johnkustin/bandgapReferenceCircuit/plots/ideal_amp/closed-loop-gain-pos-neg-vs-temp.png

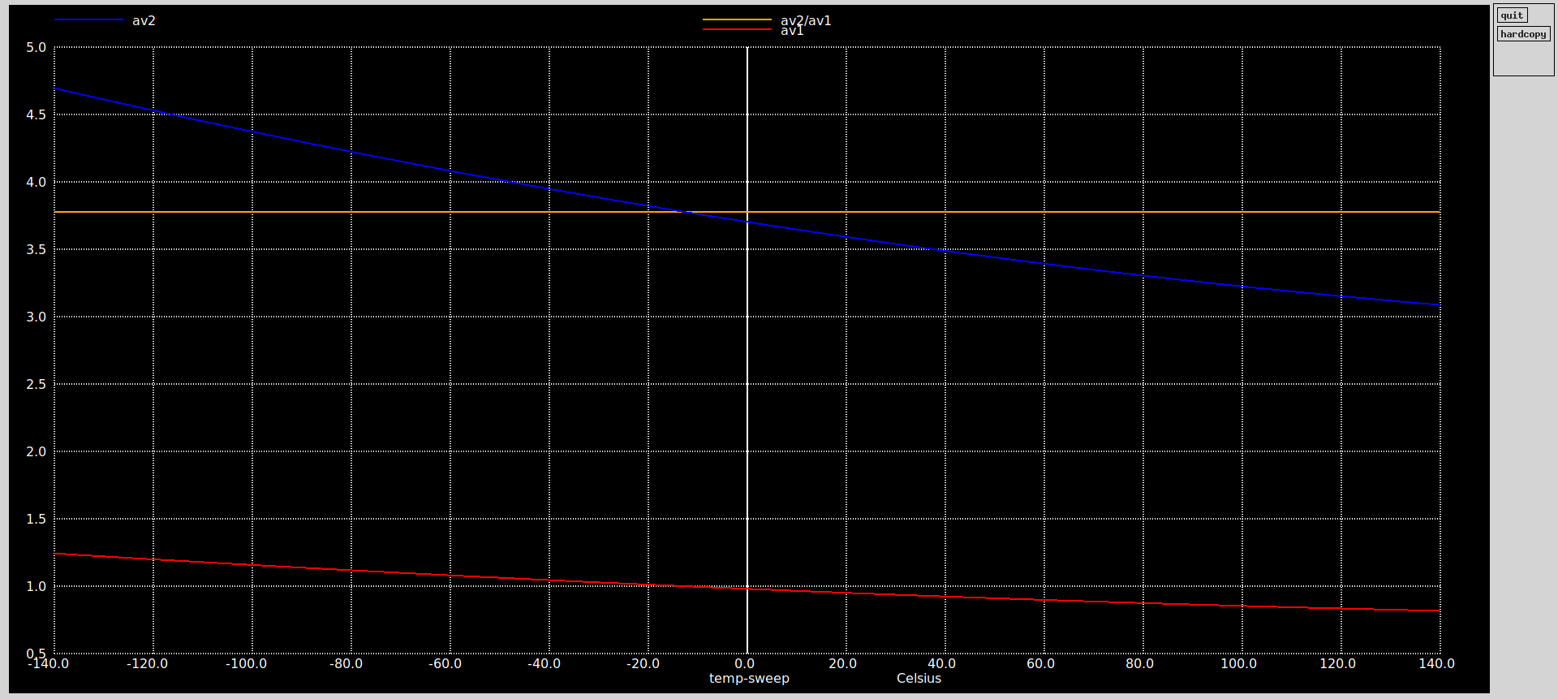
plots/ideal_amp/closed-loop-gain-pos-neg-vs-temp.png
