johnkustin/bandgapReferenceCircuit/plots/ideal_amp/current-vs-temp.png

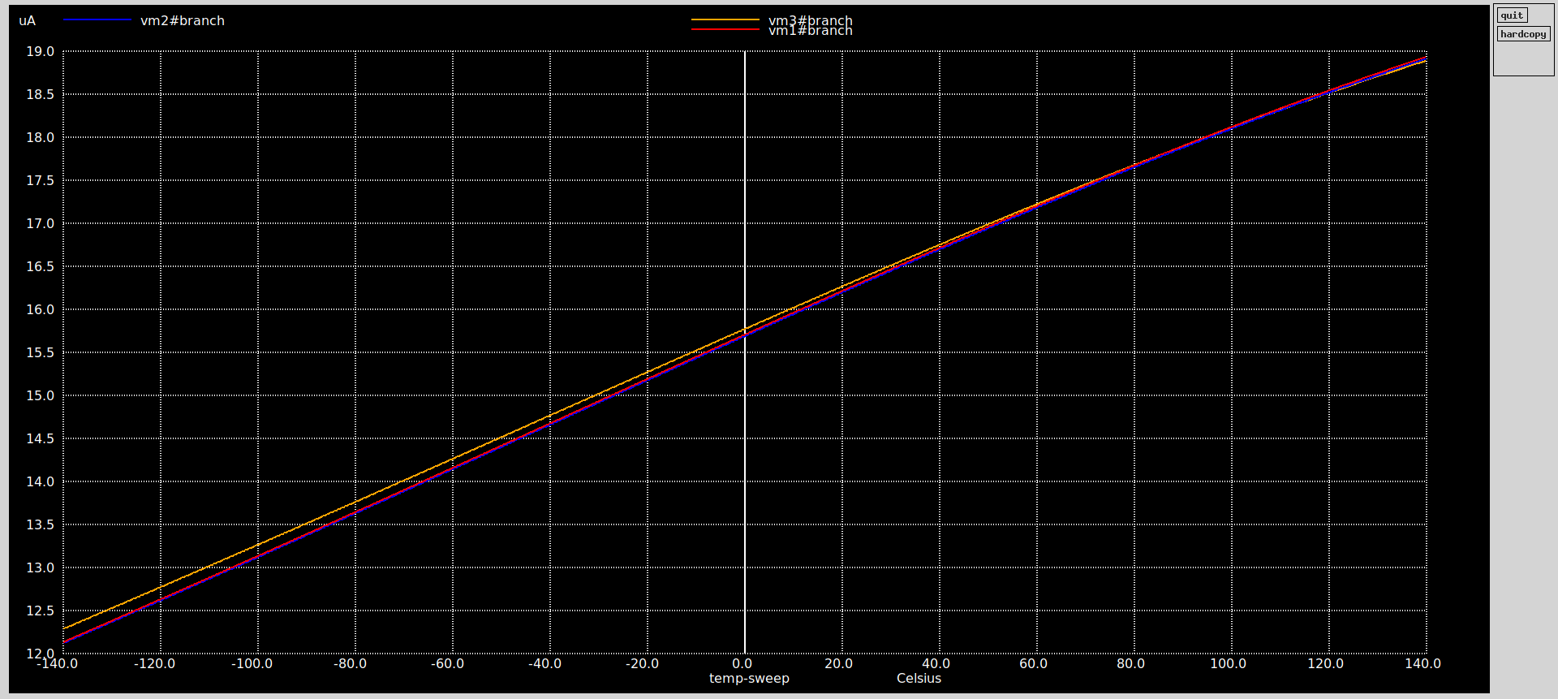
plots/ideal_amp/current-vs-temp.png
