johnkustin/bandgapReferenceCircuit/plots/ideal_amp/deriv-veb-deriv-vptat-vs-temp-zoomed.png

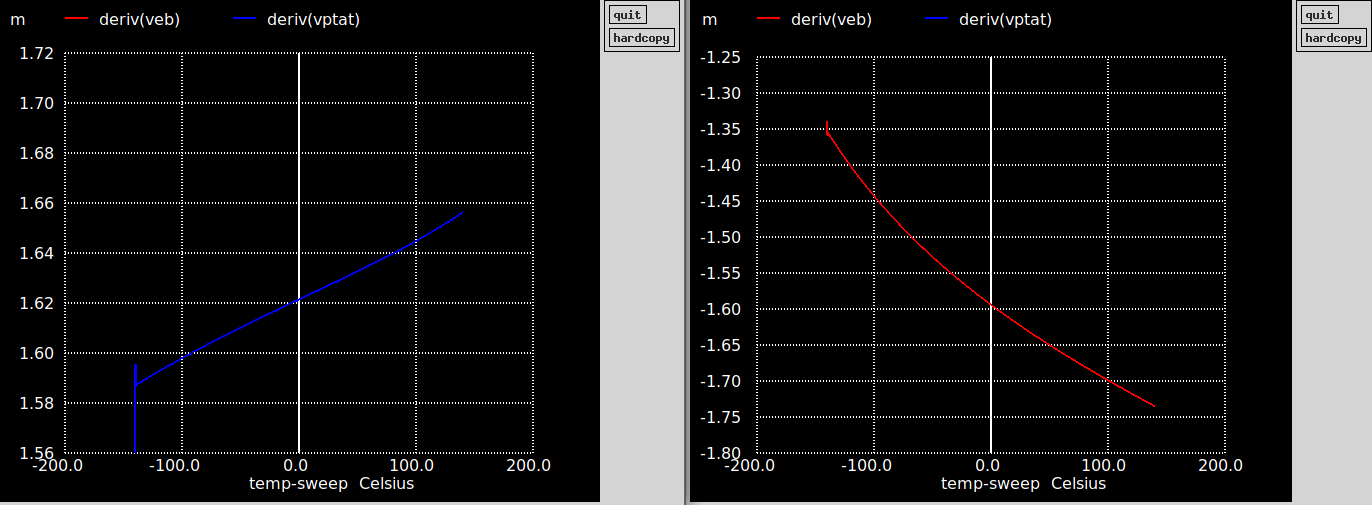
plots/ideal_amp/deriv-veb-deriv-vptat-vs-temp-zoomed.png
