johnkustin/bandgapReferenceCircuit/plots/ideal_amp/deriv-veb-deriv-vptat-vs-temp.png

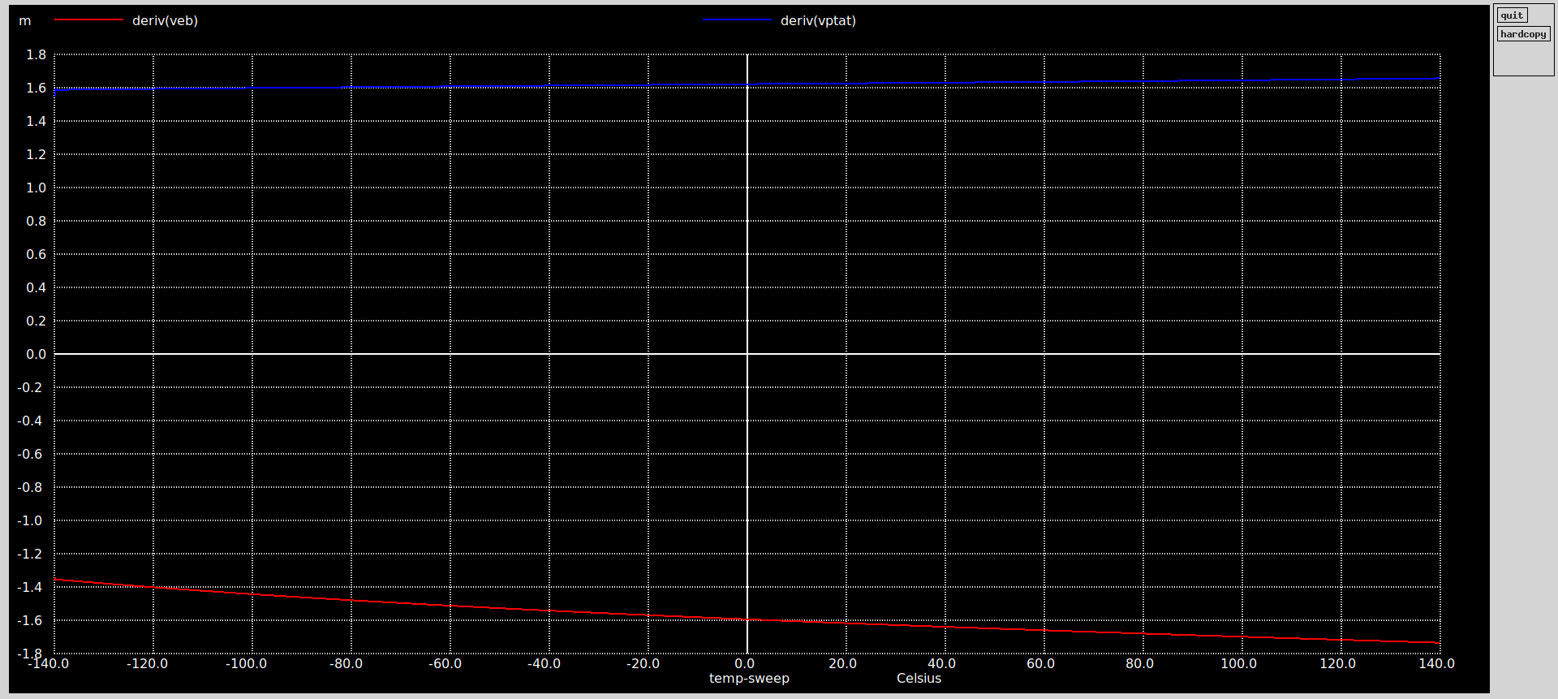
plots/ideal_amp/deriv-veb-deriv-vptat-vs-temp.png
