johnkustin/bandgapReferenceCircuit/plots/ideal_amp/ppm-vs-temp.png

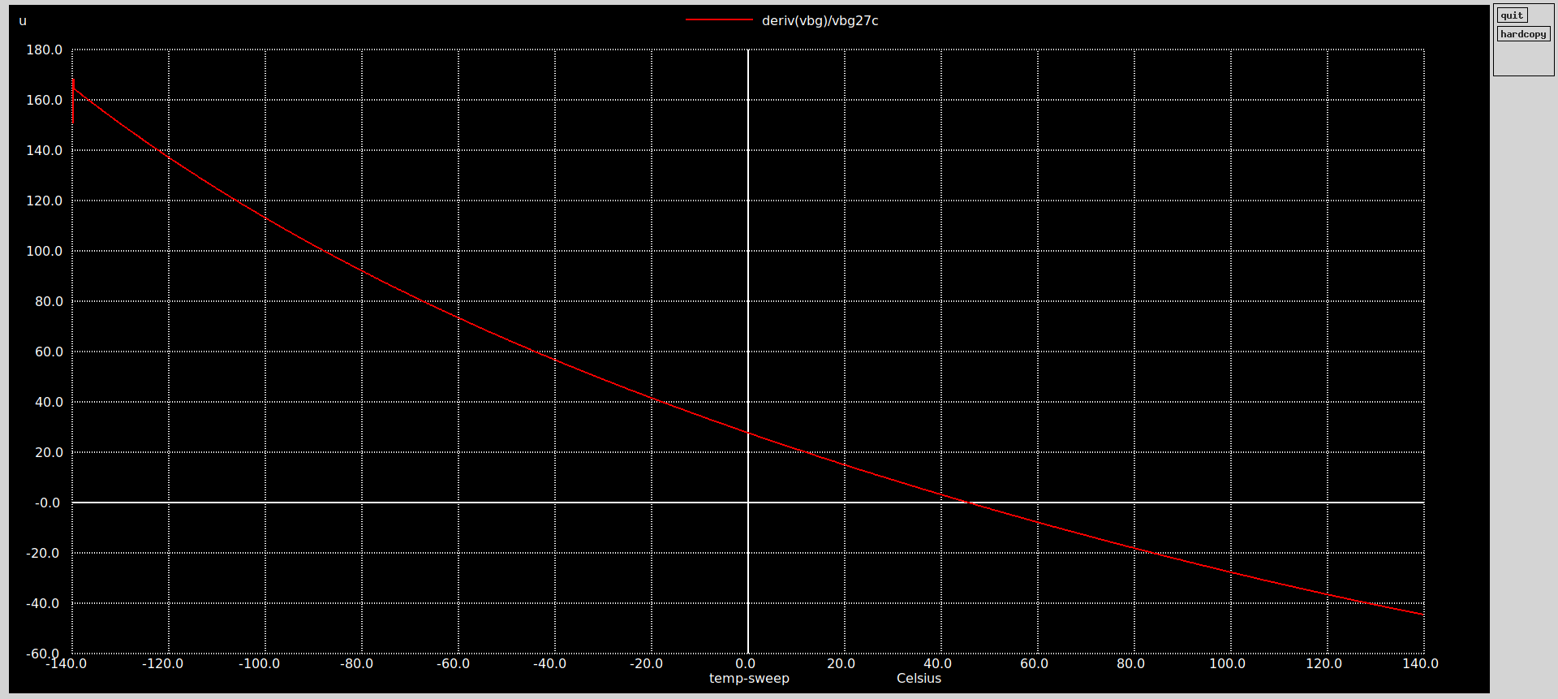
plots/ideal_amp/ppm-vs-temp.png
