johnkustin/bandgapReferenceCircuit/plots/ideal_amp/saturation-cond-vs-temp.png

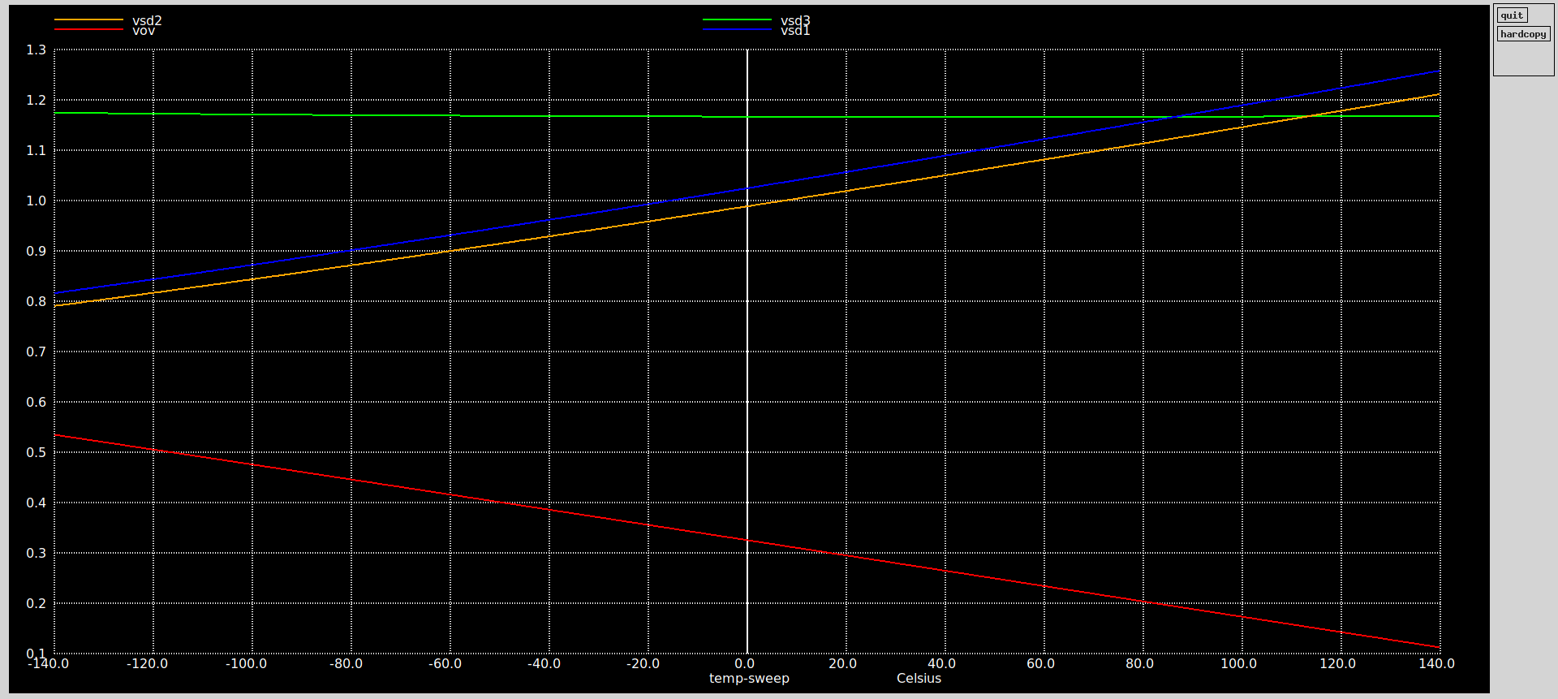
plots/ideal_amp/saturation-cond-vs-temp.png
