johnkustin/bandgapReferenceCircuit/plots/ideal_amp/vbg-vs-temp.png

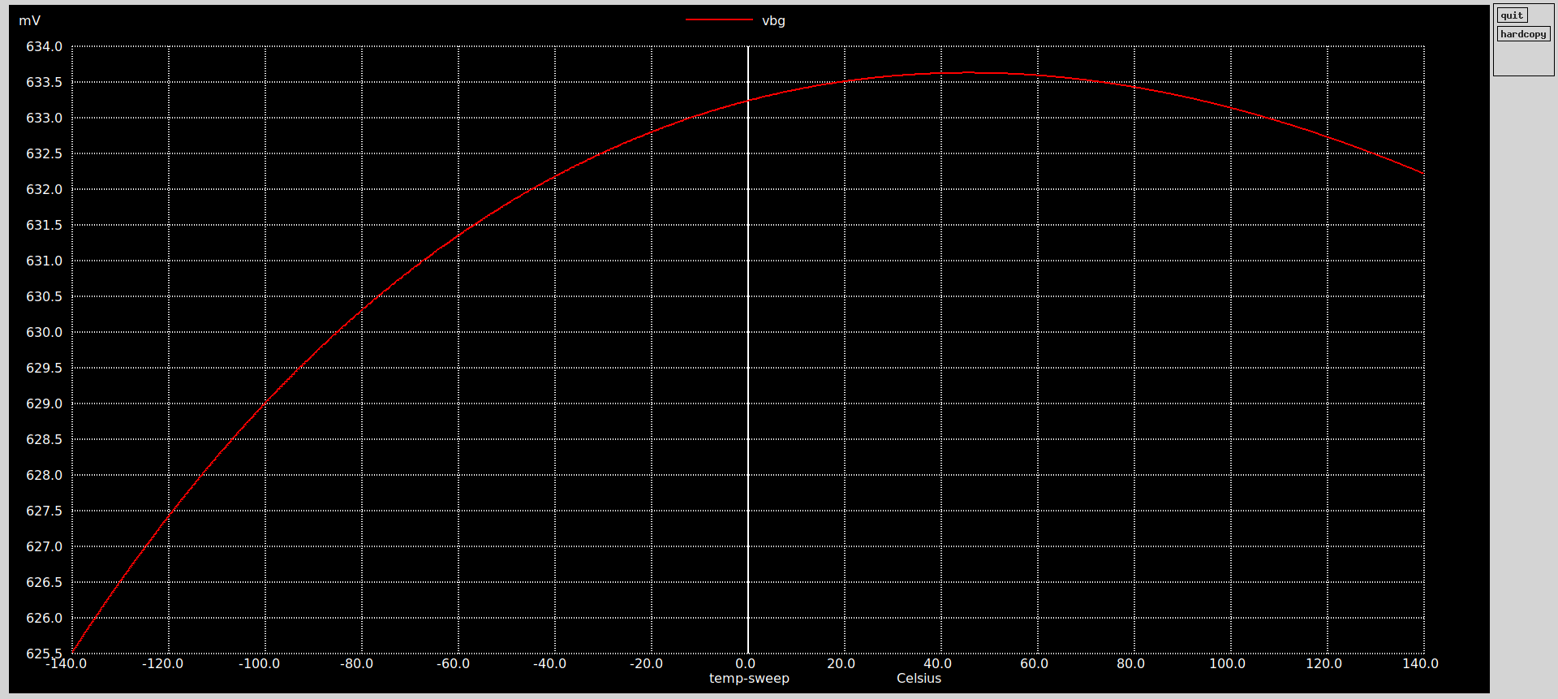
plots/ideal_amp/vbg-vs-temp.png
