johnkustin/bandgapReferenceCircuit/plots/ideal_amp/veb-vptat-sum-vs-temp.png

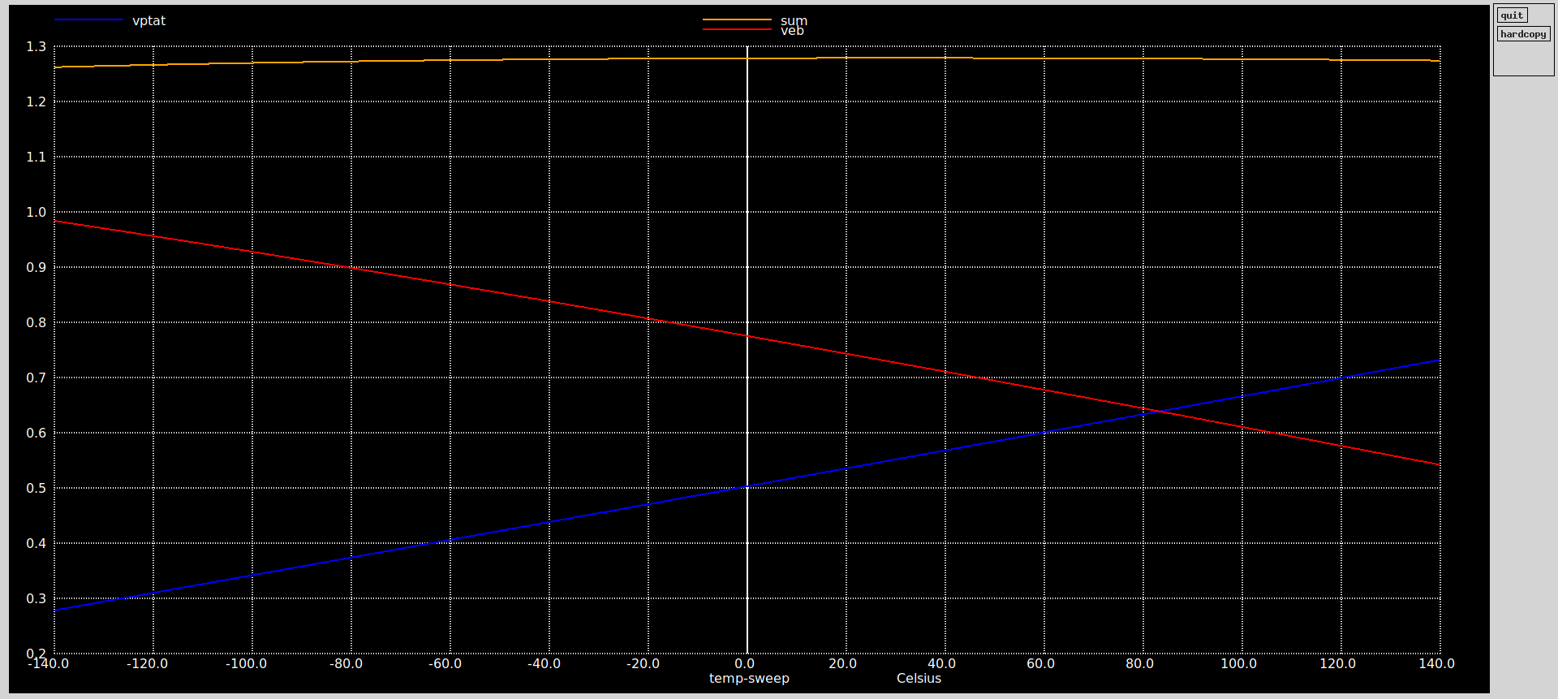
plots/ideal_amp/veb-vptat-sum-vs-temp.png
