johnkustin/bandgapReferenceCircuit/plots/ideal_amp_pdk_res/deriv-vbg-vs-temp.png

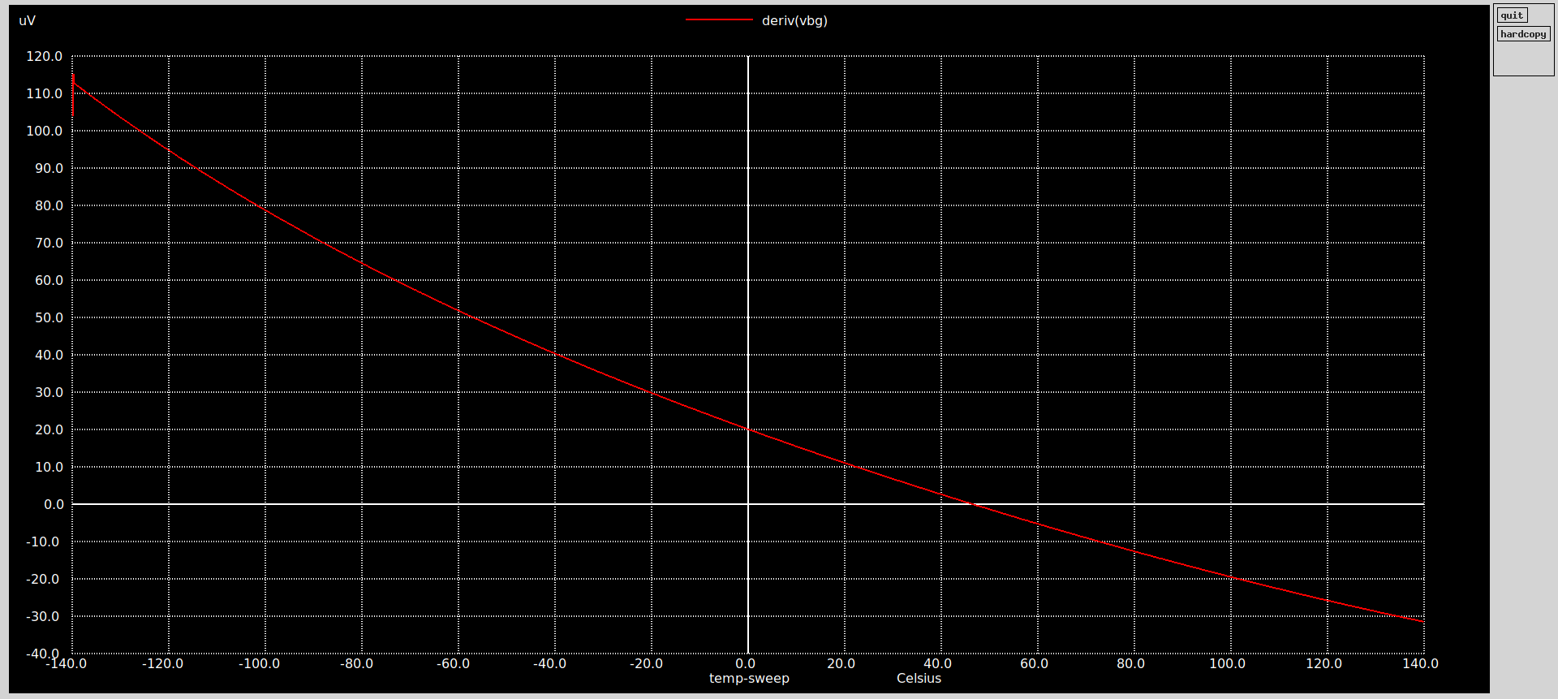
plots/ideal_amp_pdk_res/deriv-vbg-vs-temp.png
