johnkustin/bandgapReferenceCircuit/plots/ideal_amp_pdk_res/TCratio.png

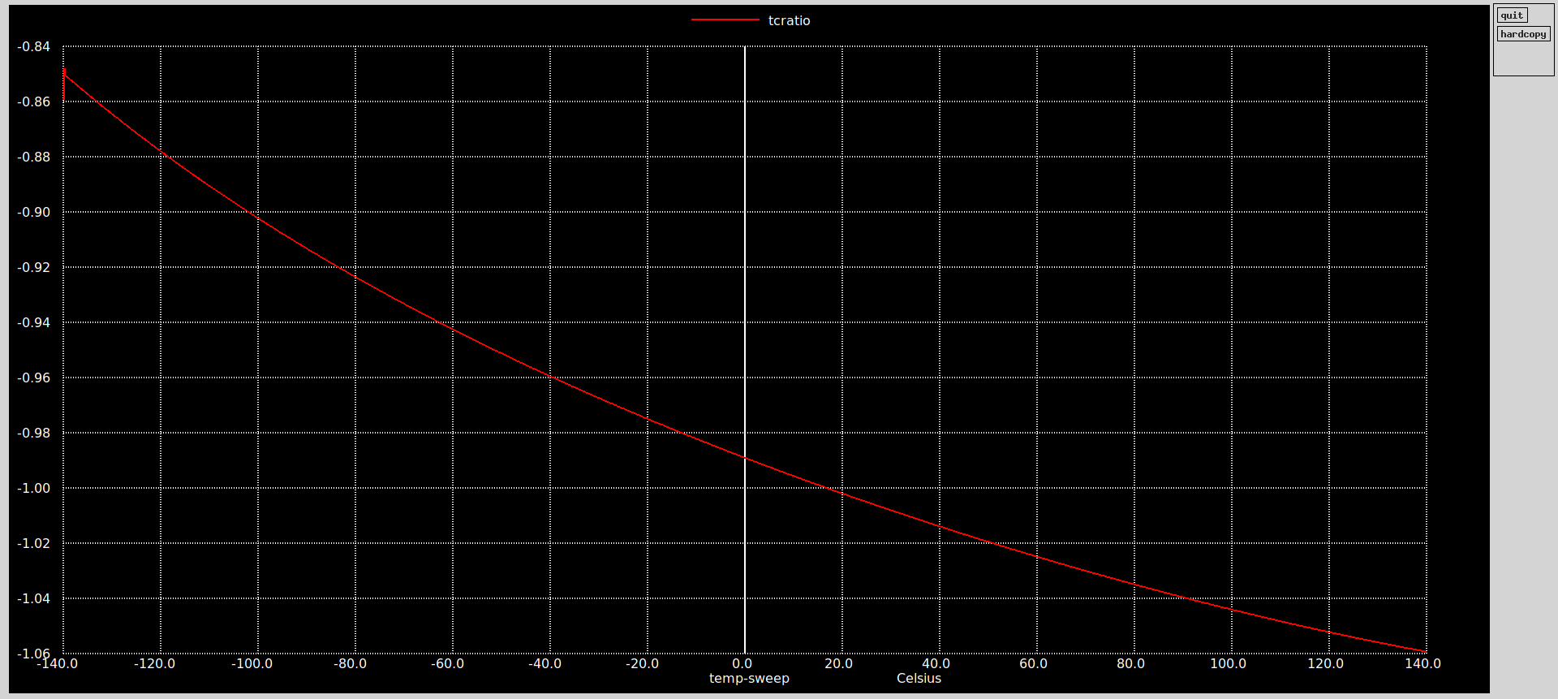
plots/ideal_amp_pdk_res/TCratio.png
