johnkustin/bandgapReferenceCircuit/plots/ideal_amp_pdk_res/vbg-vs-temp.png

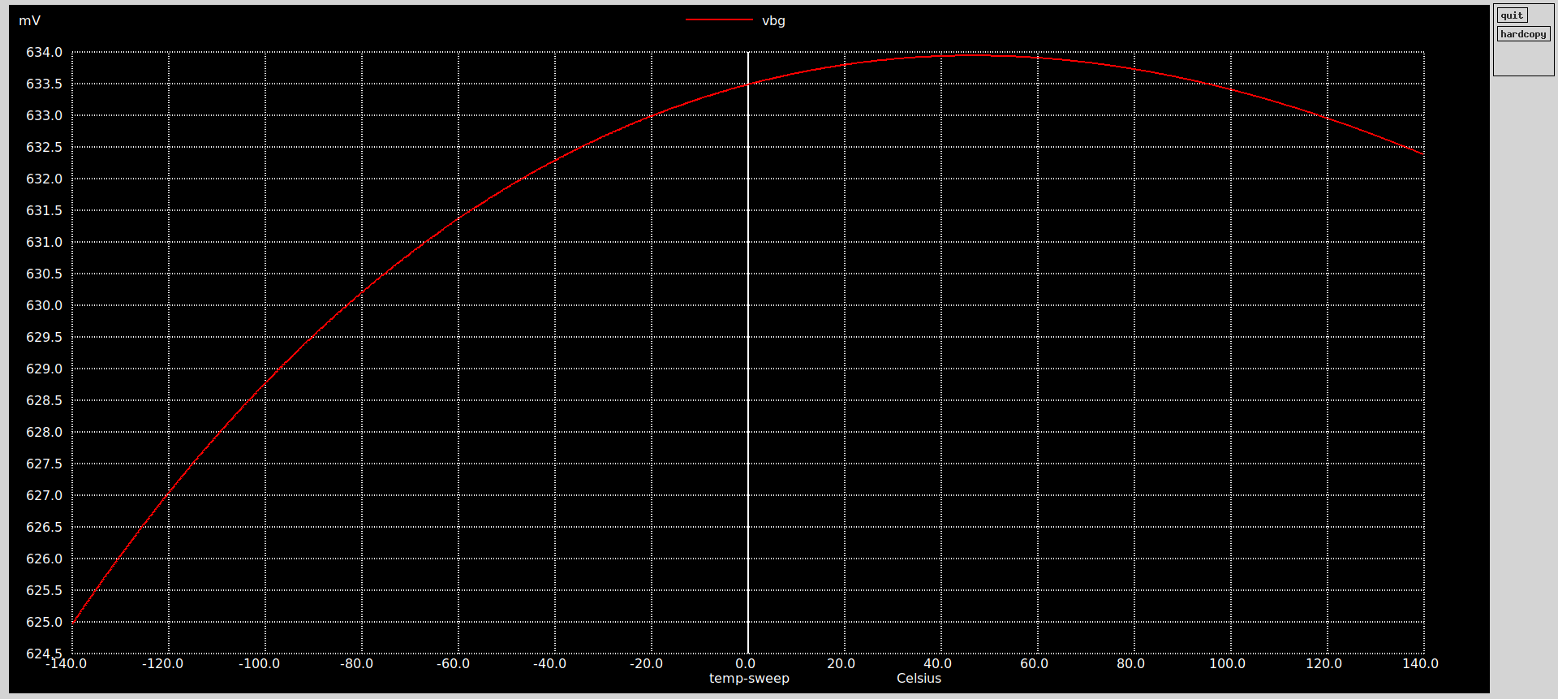
plots/ideal_amp_pdk_res/vbg-vs-temp.png
