johnkustin/bandgapReferenceCircuit/plots/ideal_bg/current-mirror-vs-temp.png

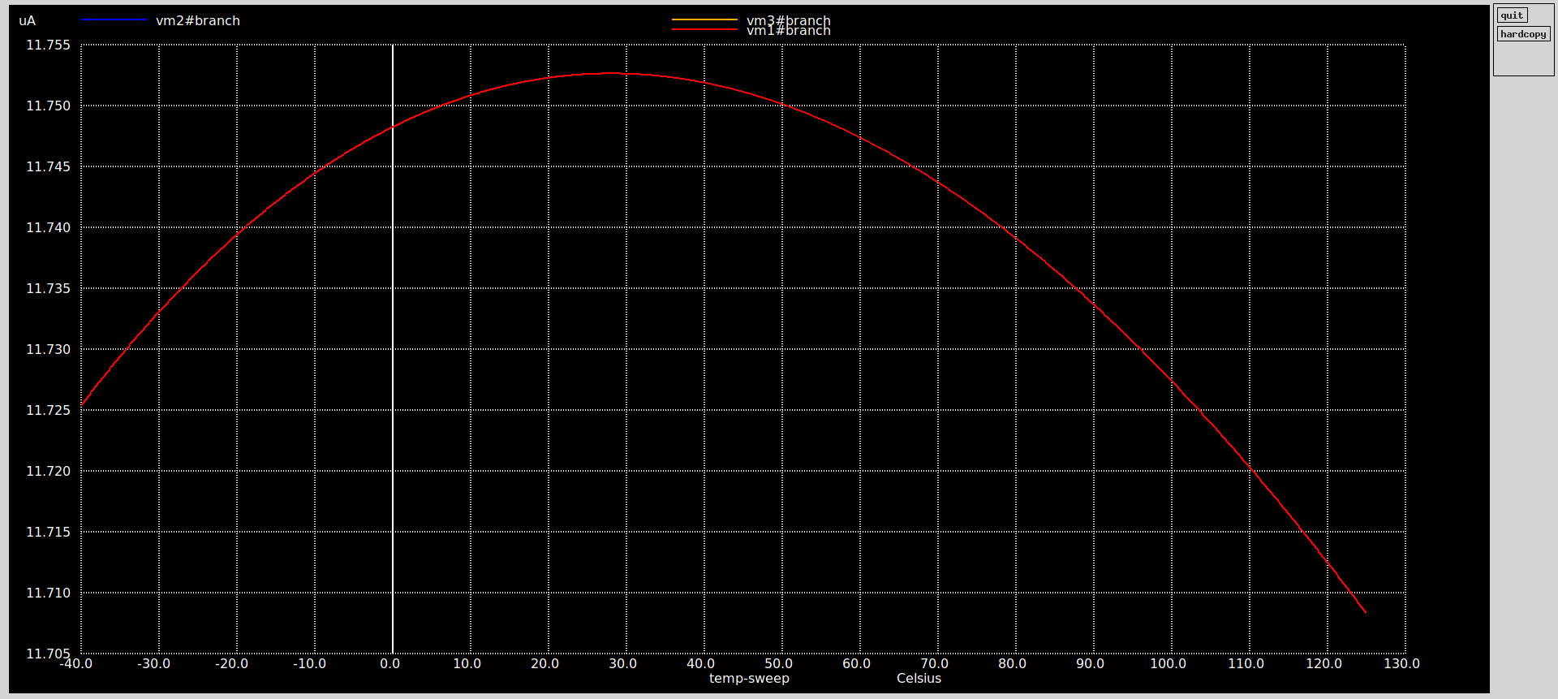
plots/ideal_bg/current-mirror-vs-temp.png
