johnkustin/bandgapReferenceCircuit/plots/ideal_bg/deriv-vbg-vs-temp.png

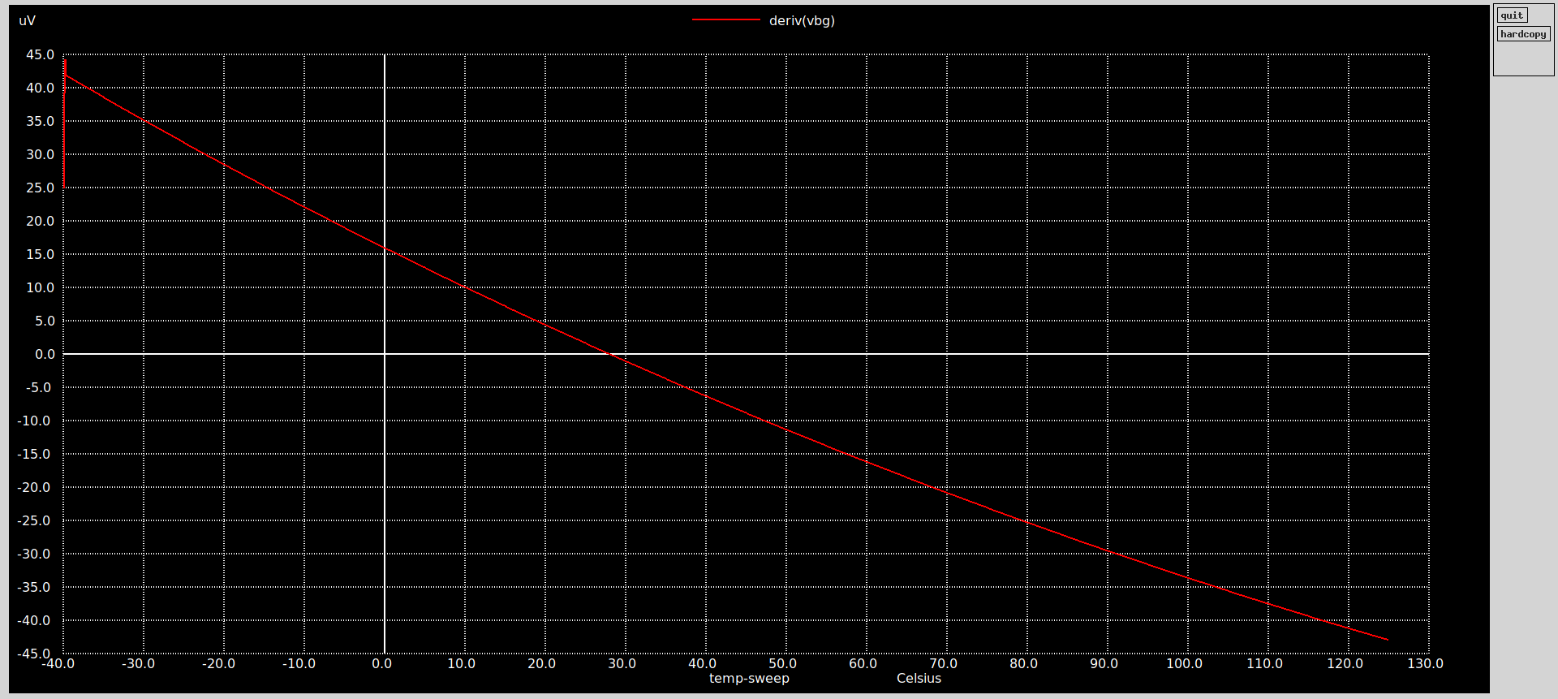
plots/ideal_bg/deriv-vbg-vs-temp.png
