johnkustin/bandgapReferenceCircuit/plots/ideal_bg/ppm-vs-temp.png

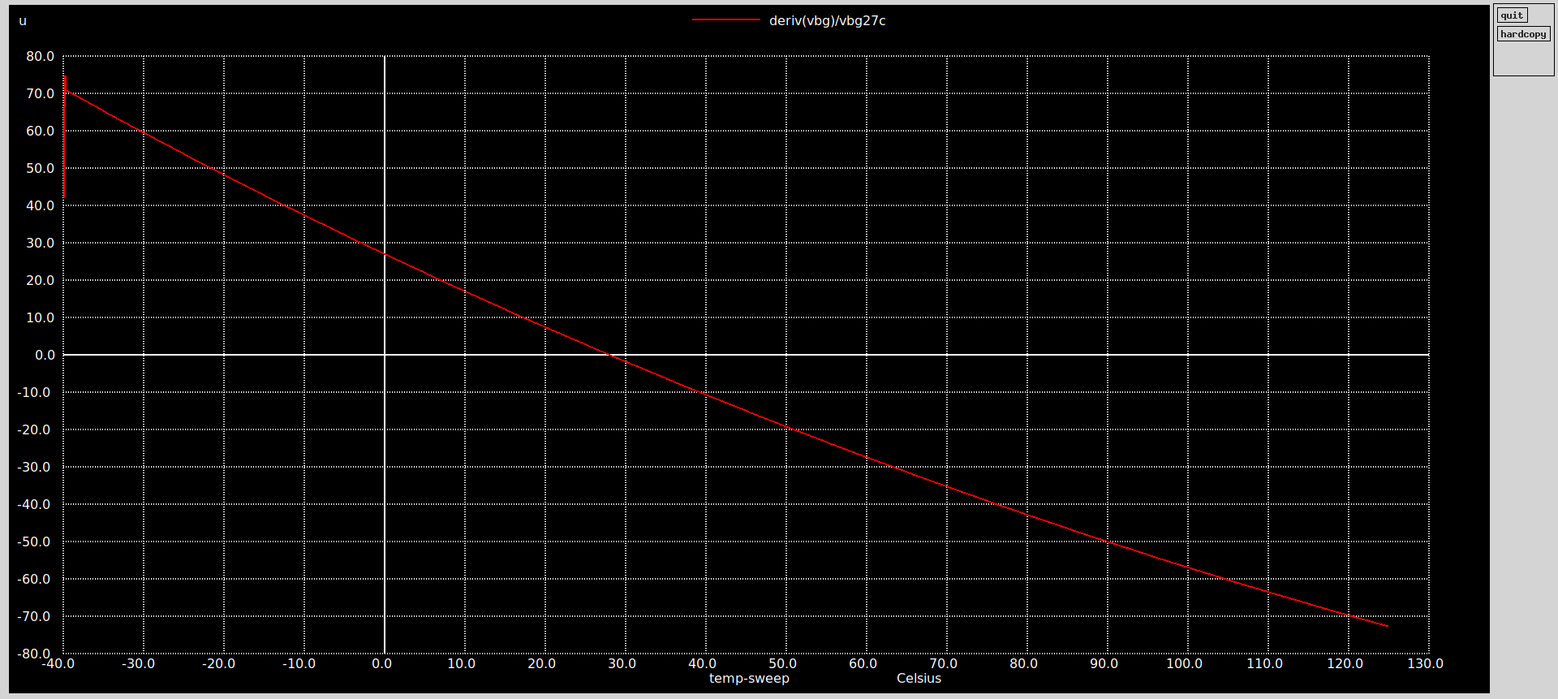
plots/ideal_bg/ppm-vs-temp.png
