johnkustin/bandgapReferenceCircuit/plots/ideal_bg/TCratio.png

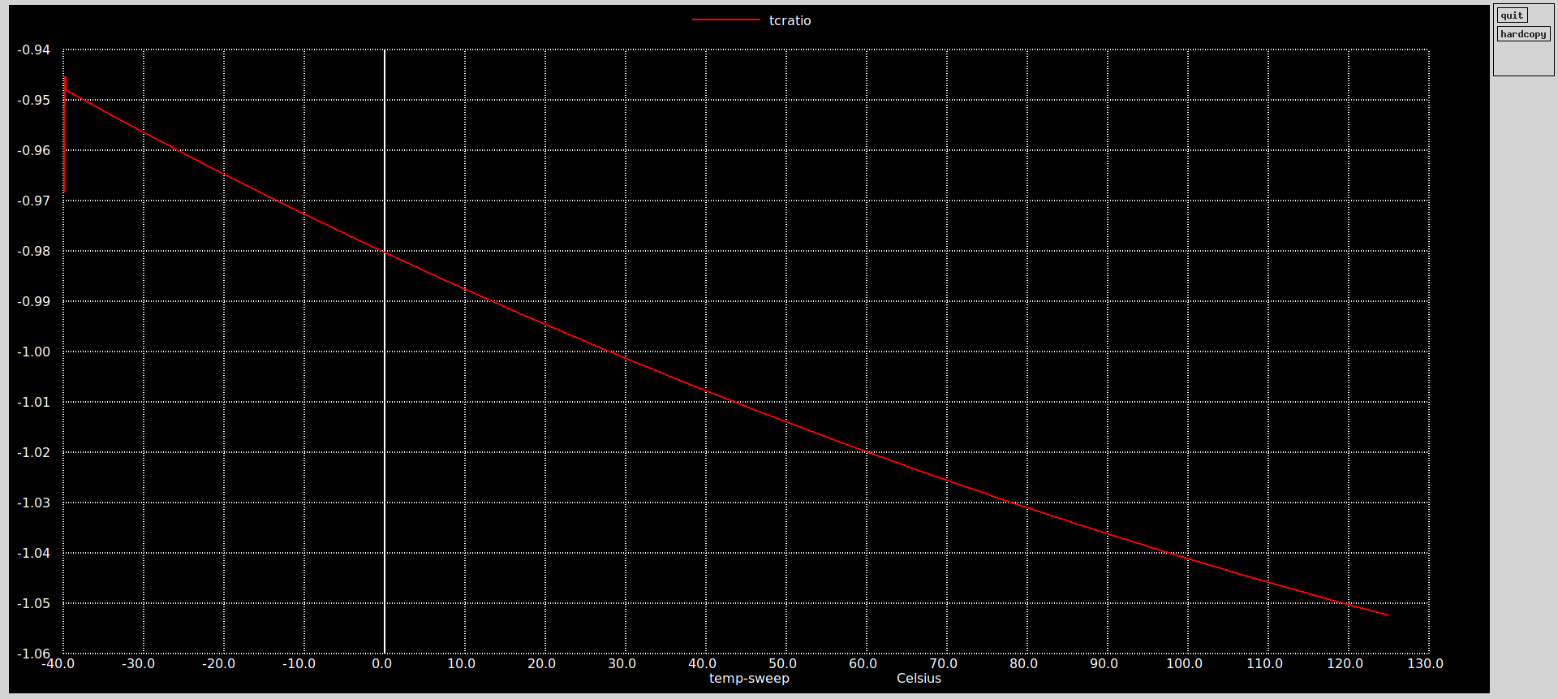
plots/ideal_bg/TCratio.png
