johnkustin/bandgapReferenceCircuit/plots/ideal_bg/vbg-vs-temp.png

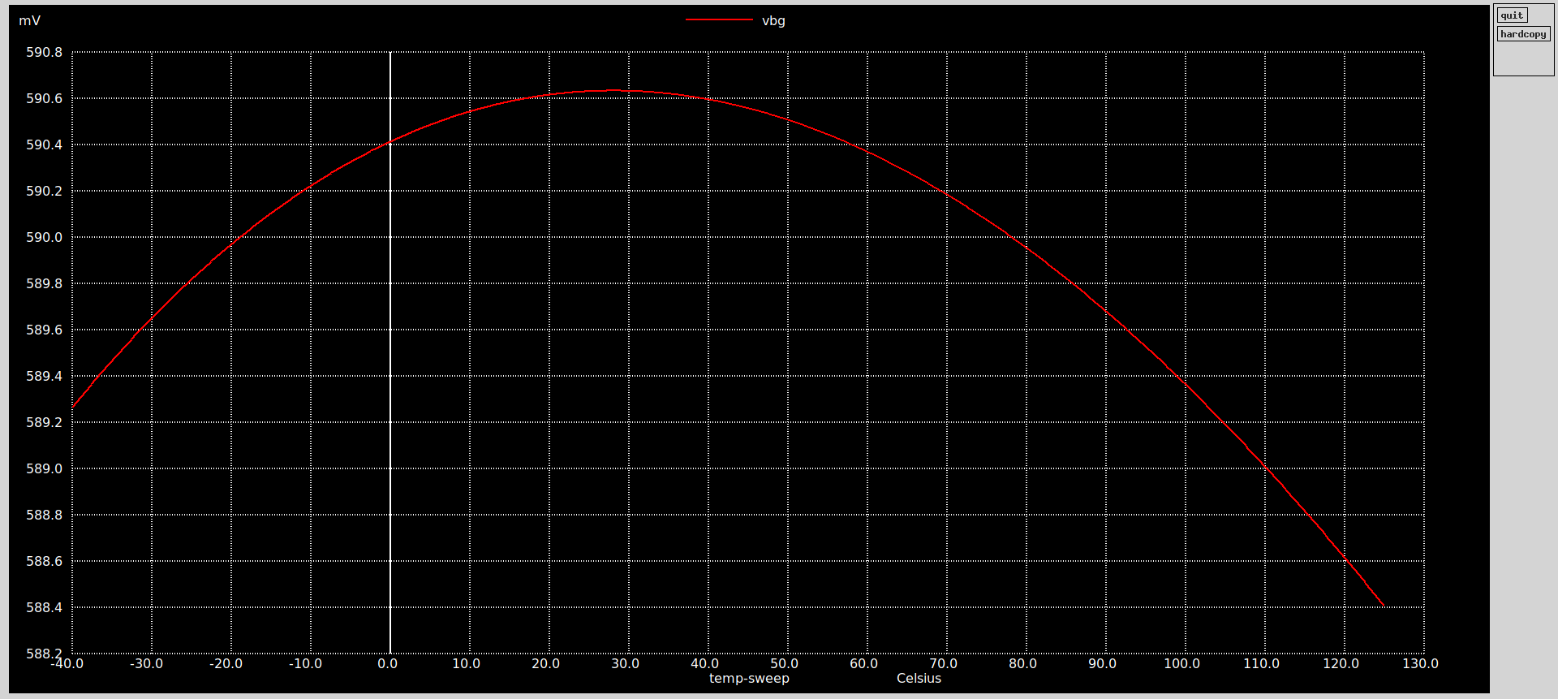
plots/ideal_bg/vbg-vs-temp.png
