johnkustin/bandgapReferenceCircuit/plots/ideal_bg/veb-plus-vptat.png

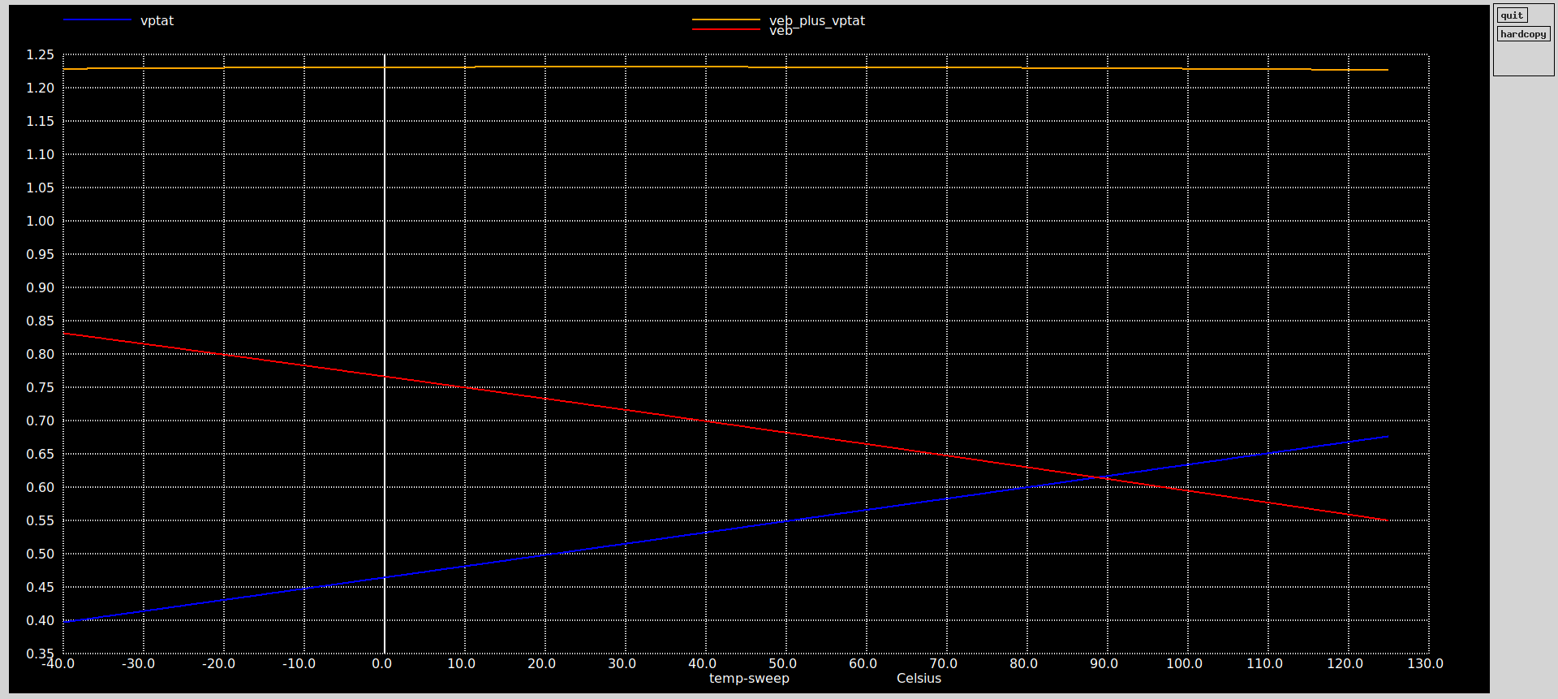
plots/ideal_bg/veb-plus-vptat.png
