johnkustin/bandgapReferenceCircuit/plots/ideal_bg/veb-vptat.png

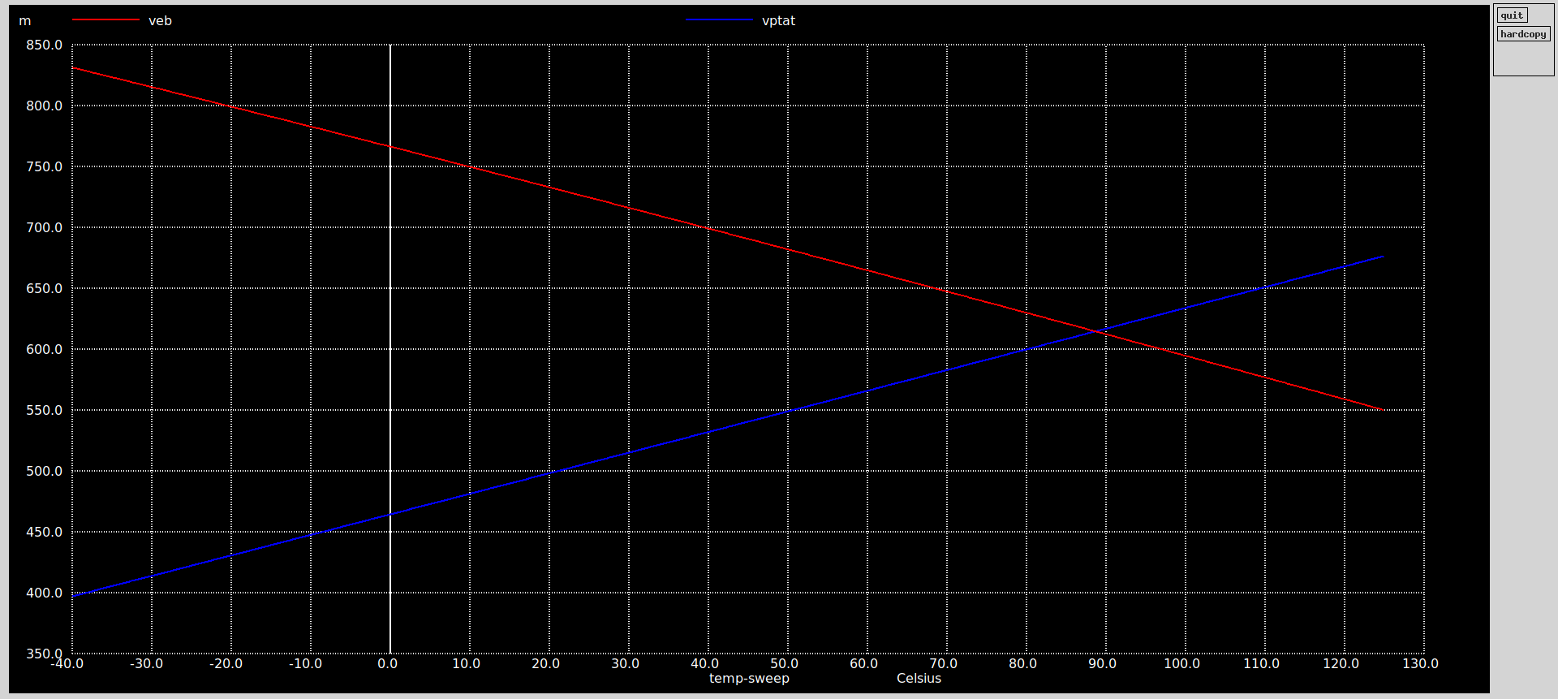
plots/ideal_bg/veb-vptat.png
