johnkustin/bandgapReferenceCircuit/plots/ideal_fb/deriv-vbg-deriv-vptat-v-temp.png

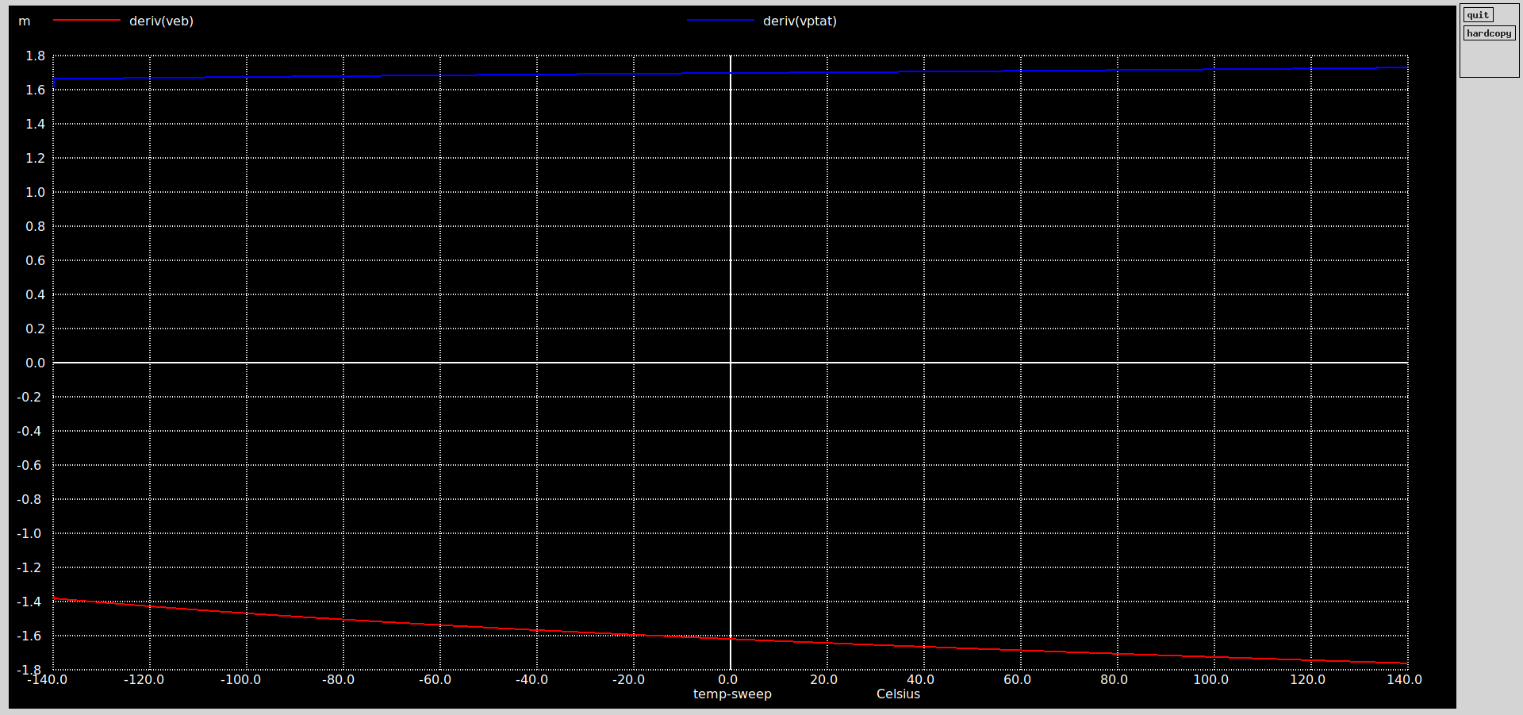
plots/ideal_fb/deriv-vbg-deriv-vptat-v-temp.png
