johnkustin/bandgapReferenceCircuit/plots/ideal_fb/vgate-v-temp.png

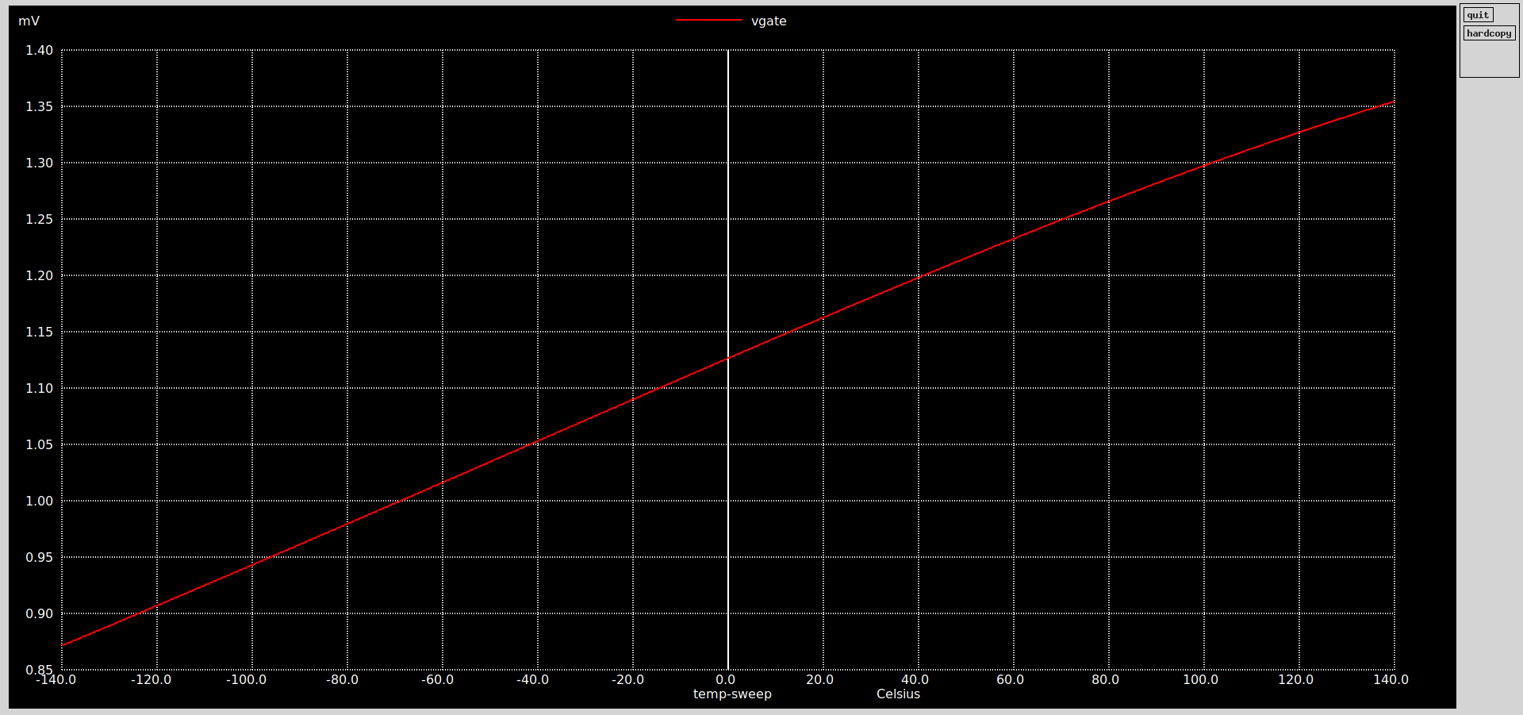
plots/ideal_fb/vgate-v-temp.png
