johnkustin/bandgapReferenceCircuit/plots/ideal_fb_pdk_res/deriv-vbg-v-temp.png

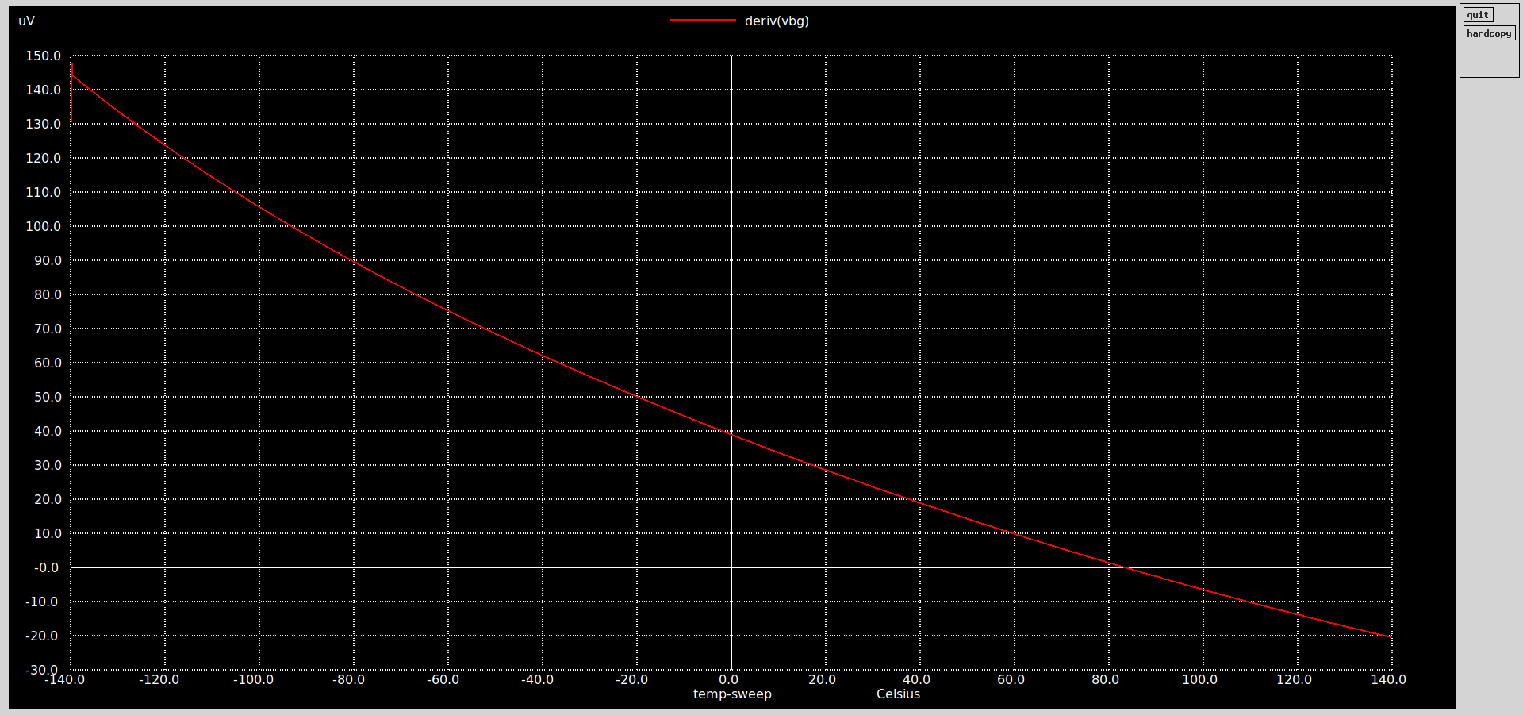
plots/ideal_fb_pdk_res/deriv-vbg-v-temp.png
