johnkustin/bandgapReferenceCircuit/plots/ideal_fb_pdk_res/deriv-veb-deriv-vptat-zoom.png

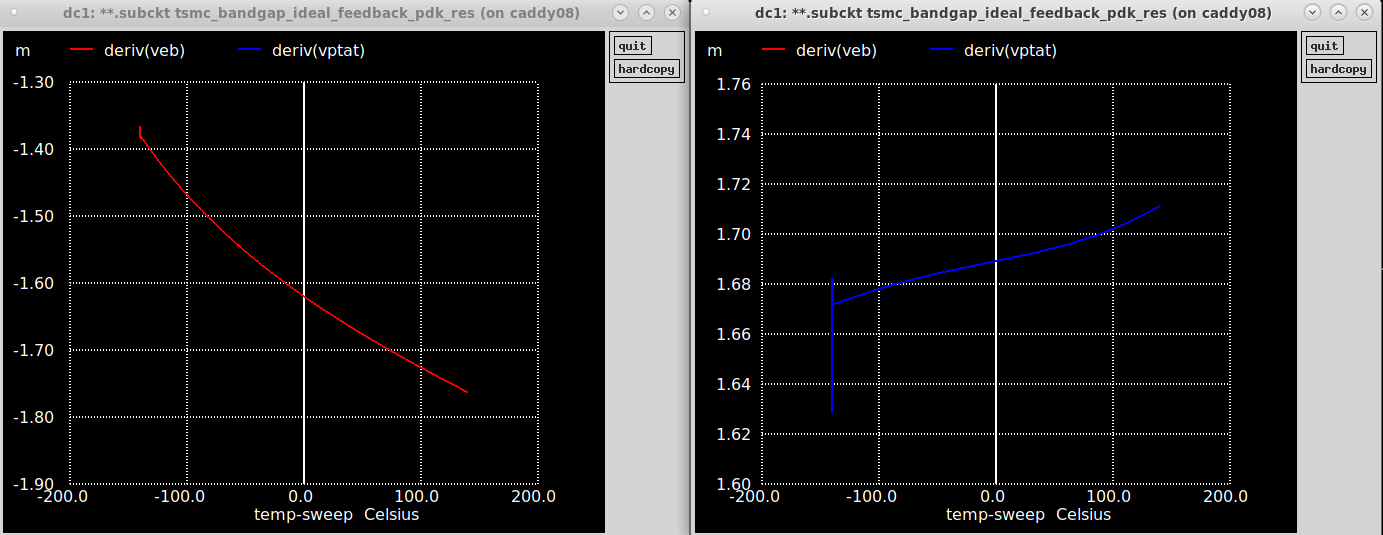
plots/ideal_fb_pdk_res/deriv-veb-deriv-vptat-zoom.png
