johnkustin/bandgapReferenceCircuit/plots/ideal_fb_pdk_res/ppm-v-temp.png

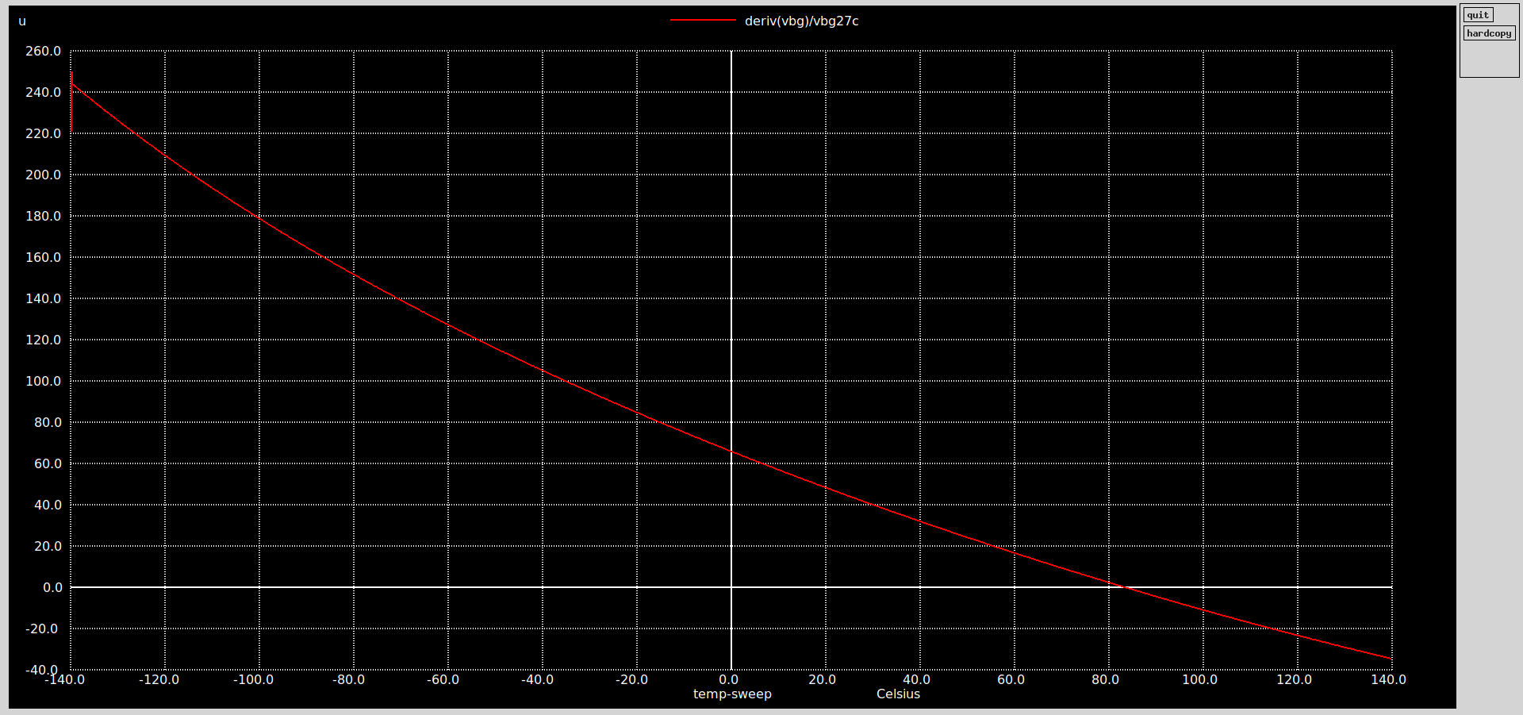
plots/ideal_fb_pdk_res/ppm-v-temp.png
