johnkustin/bandgapReferenceCircuit/plots/ideal_fb_pdk_res/TCratio.png

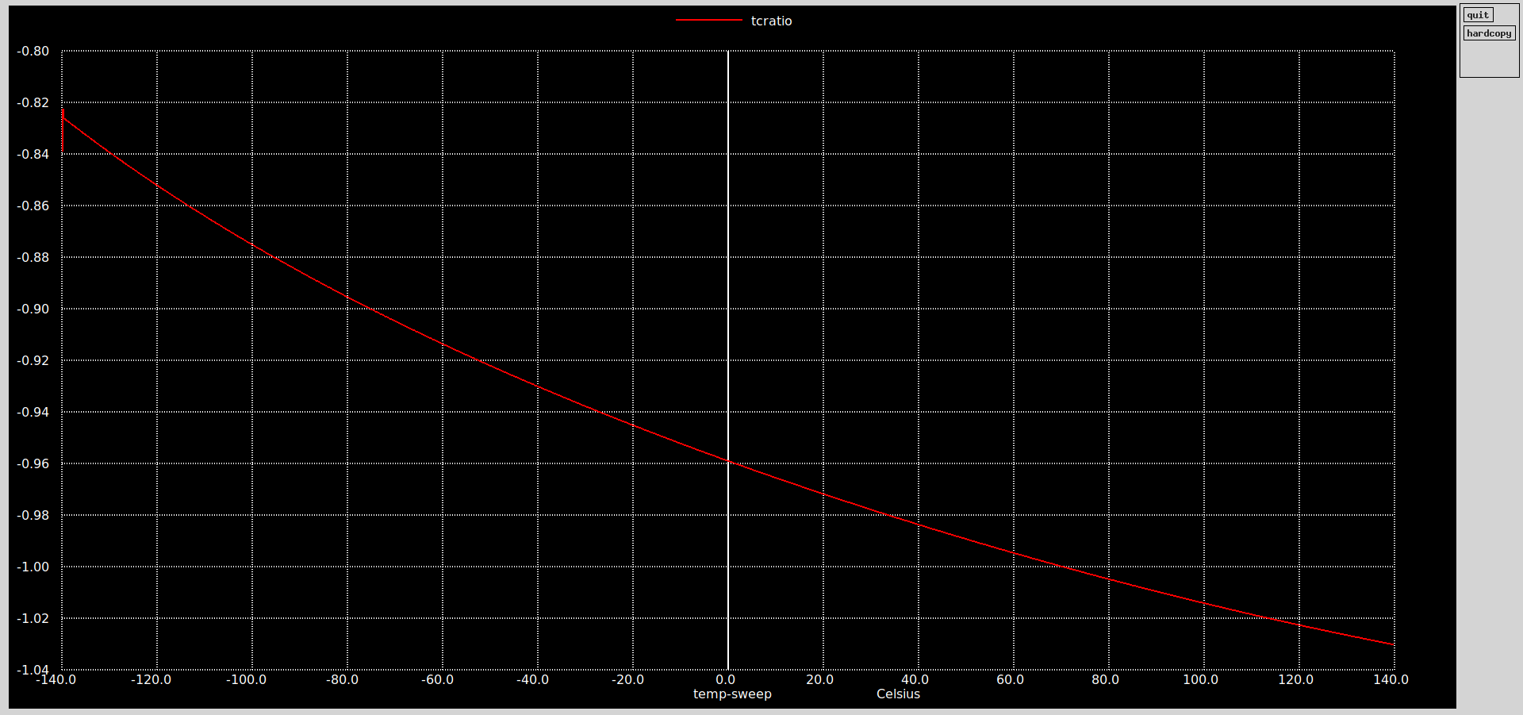
plots/ideal_fb_pdk_res/TCratio.png
