johnkustin/bandgapReferenceCircuit/plots/ideal_fb_pdk_res/vbg-v-temp.png

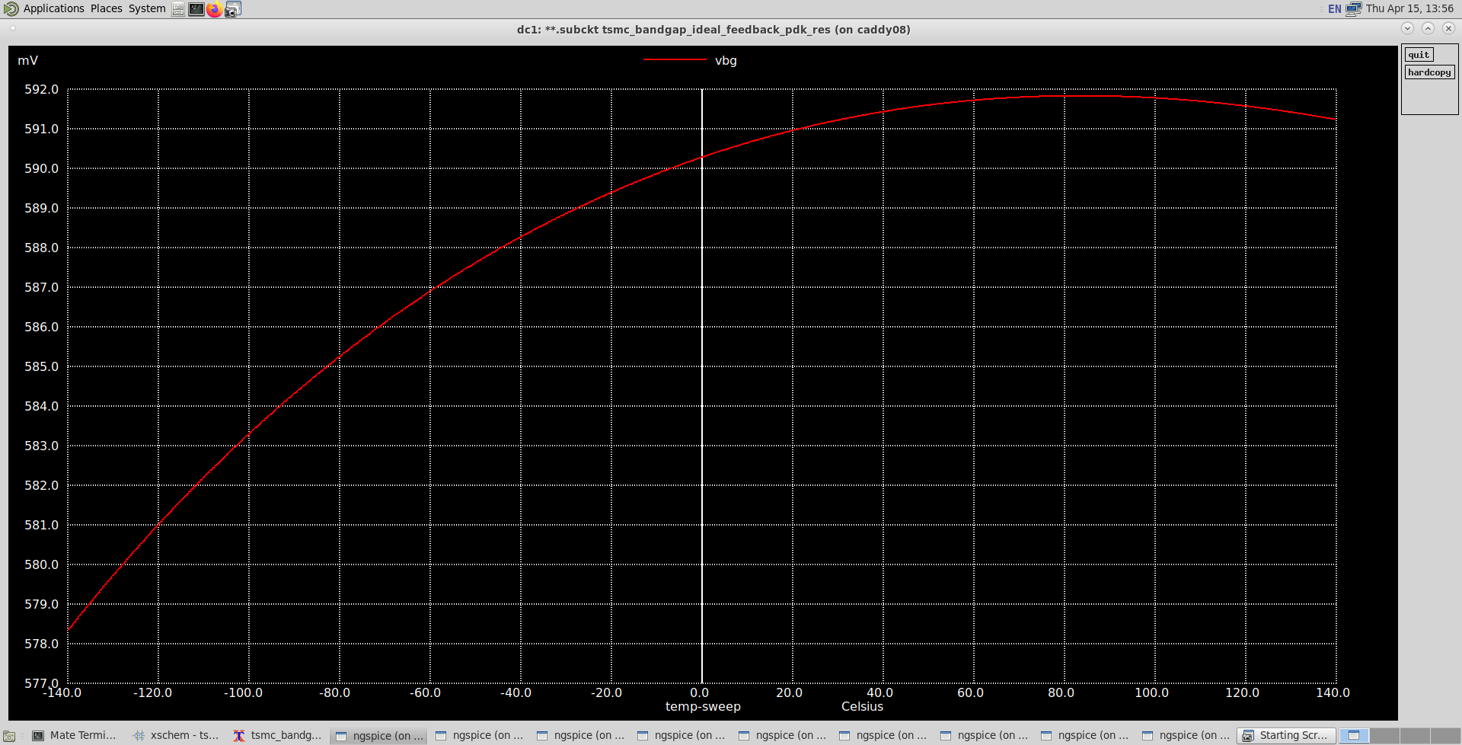
plots/ideal_fb_pdk_res/vbg-v-temp.png
