johnkustin/bandgapReferenceCircuit/plots/ideal_fb_pdk_res/veb-vptat-sum.png

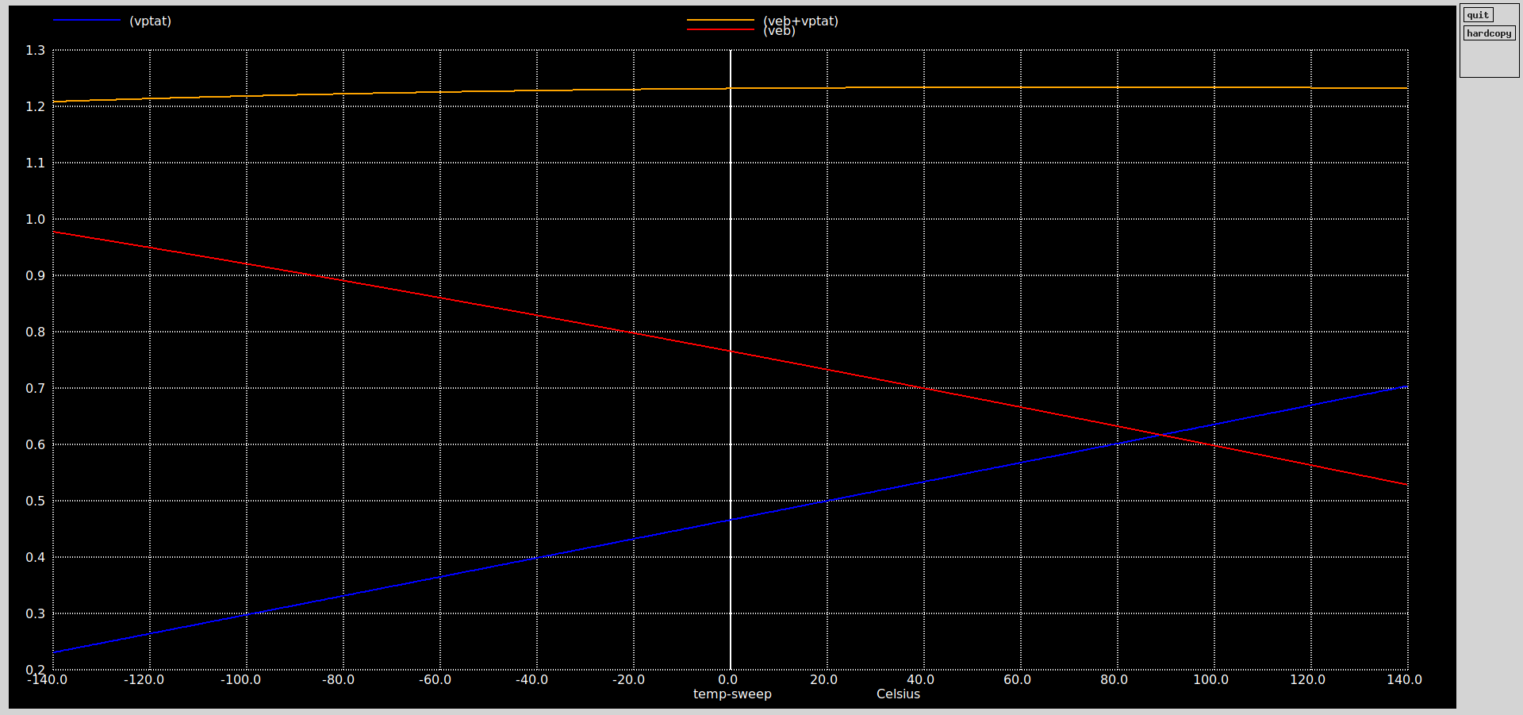
plots/ideal_fb_pdk_res/veb-vptat-sum.png
