johnkustin/bandgapReferenceCircuit/plots/ideal_res_amp/closed-loop-gain-pos-neg-vs-temp.png

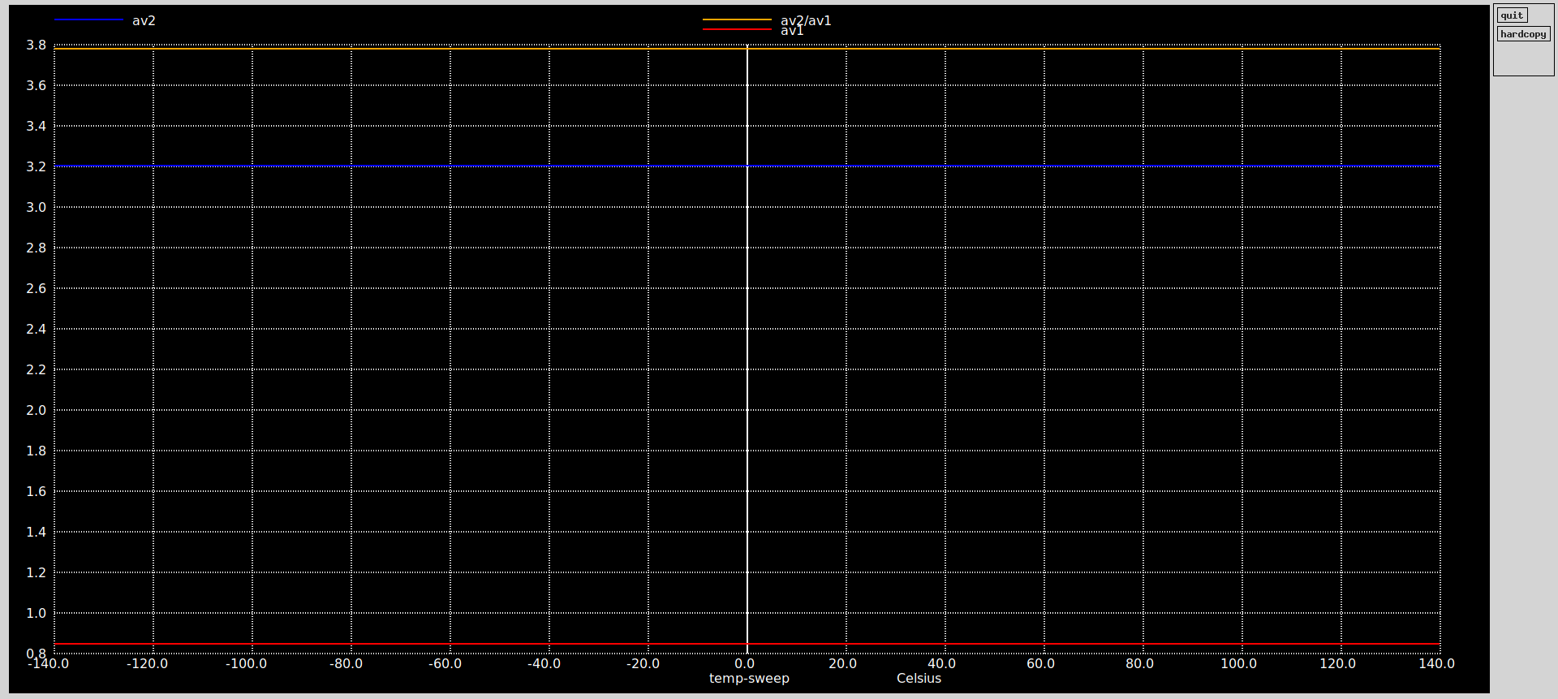
plots/ideal_res_amp/closed-loop-gain-pos-neg-vs-temp.png
