johnkustin/bandgapReferenceCircuit/plots/layout-checkpoint/hist_0degc.png

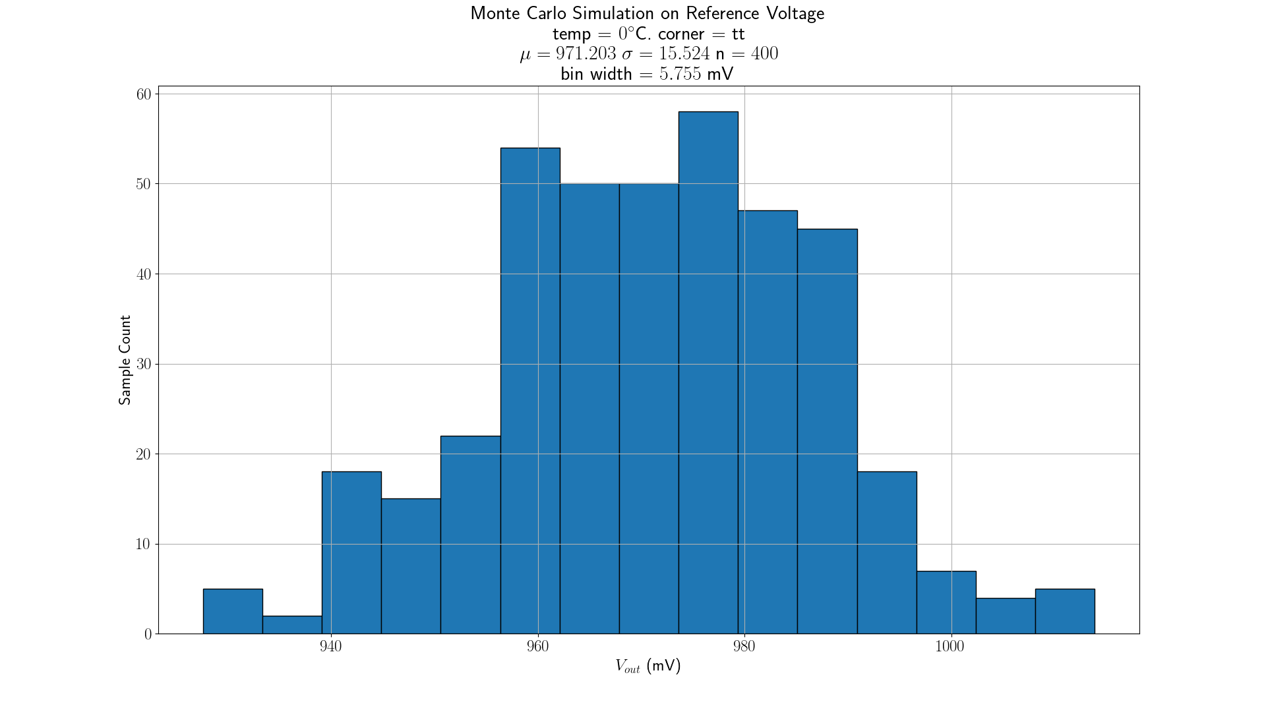
plots/layout-checkpoint/hist_0degc.png
