johnkustin/bandgapReferenceCircuit/plots/layout-checkpoint/hist_overlay_degc.png

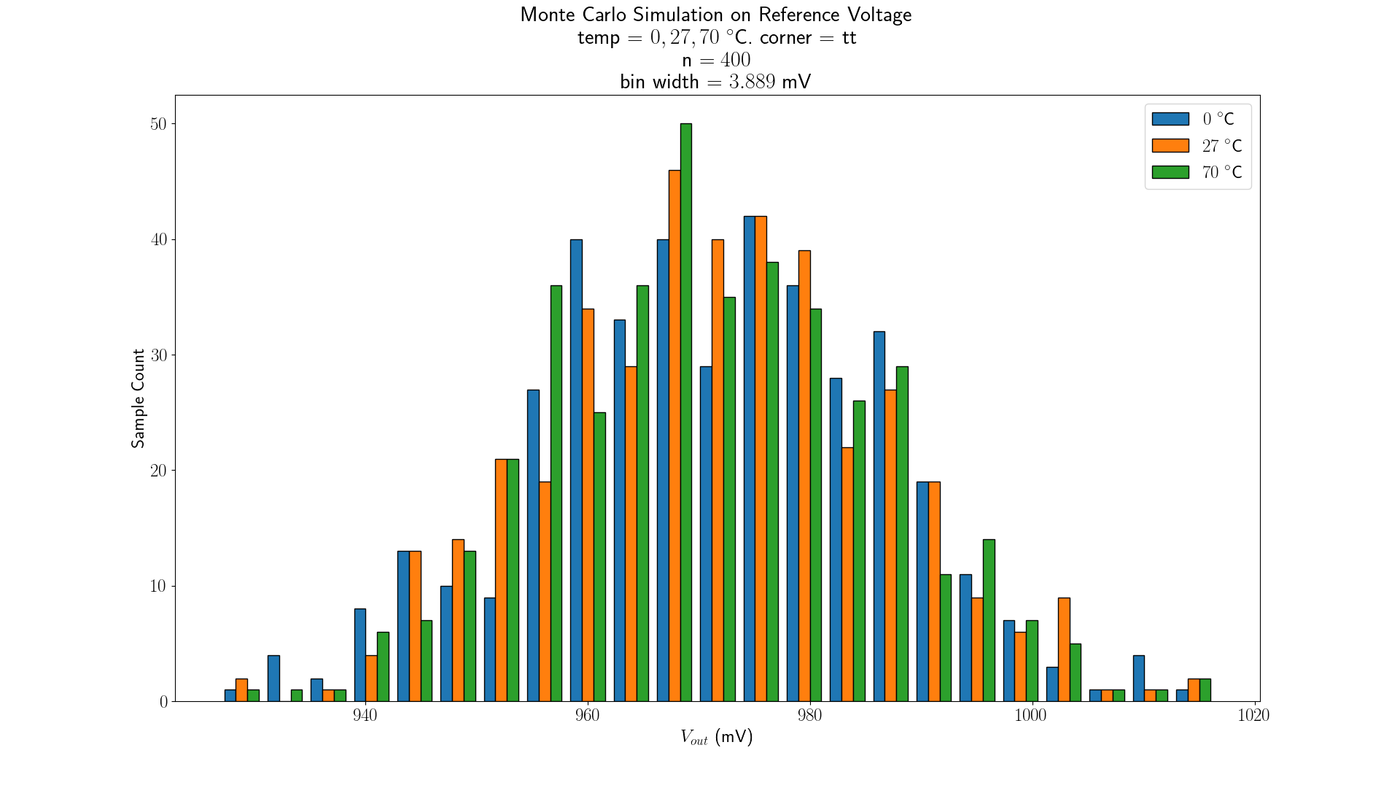
plots/layout-checkpoint/hist_overlay_degc.png
