johnkustin/bandgapReferenceCircuit/plots/layout-checkpoint/hist_ppm.png

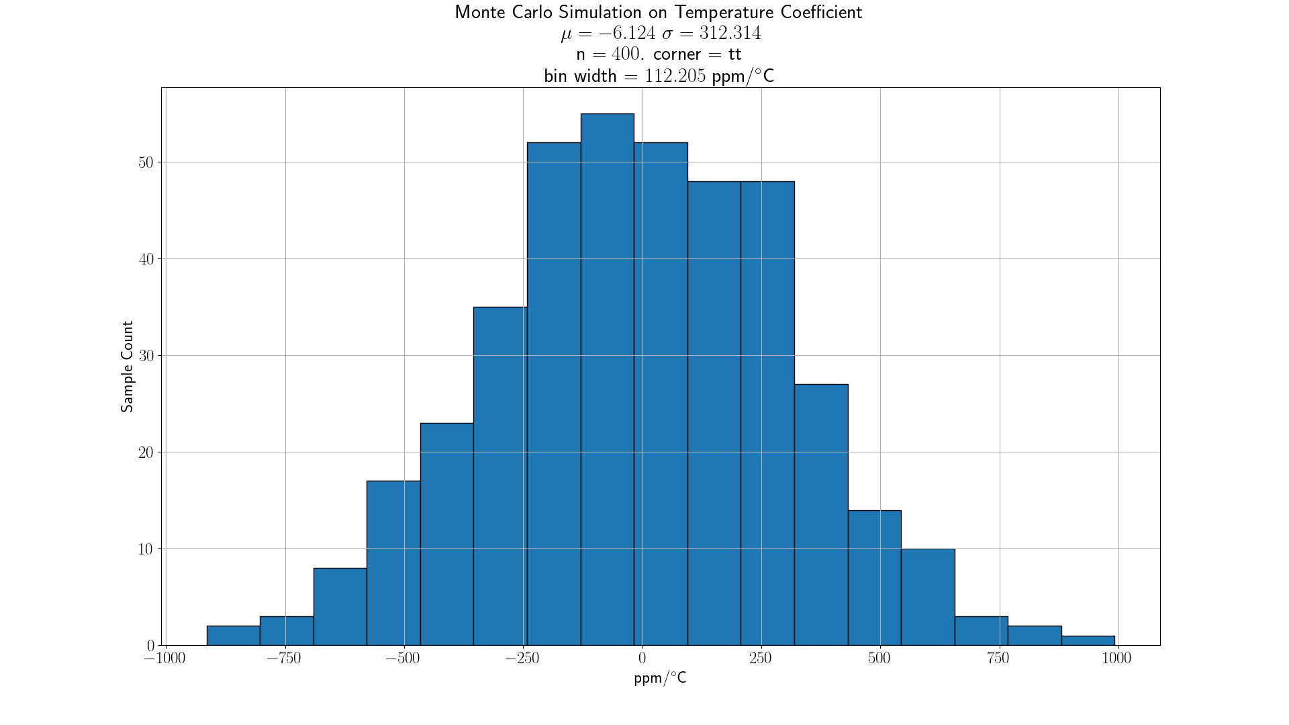
plots/layout-checkpoint/hist_ppm.png
