johnkustin/bandgapReferenceCircuit/plots/layout-checkpoint/layout.png

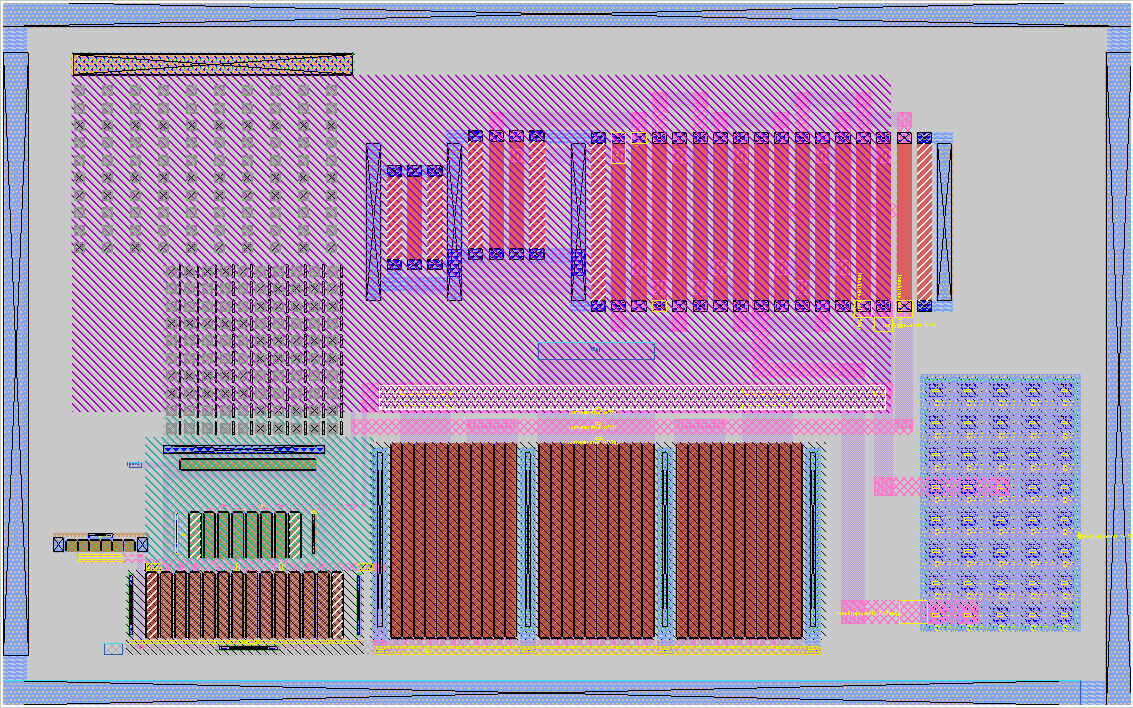
plots/layout-checkpoint/layout.png
