johnkustin/bandgapReferenceCircuit/plots/layout-checkpoint/ppm_ff.png

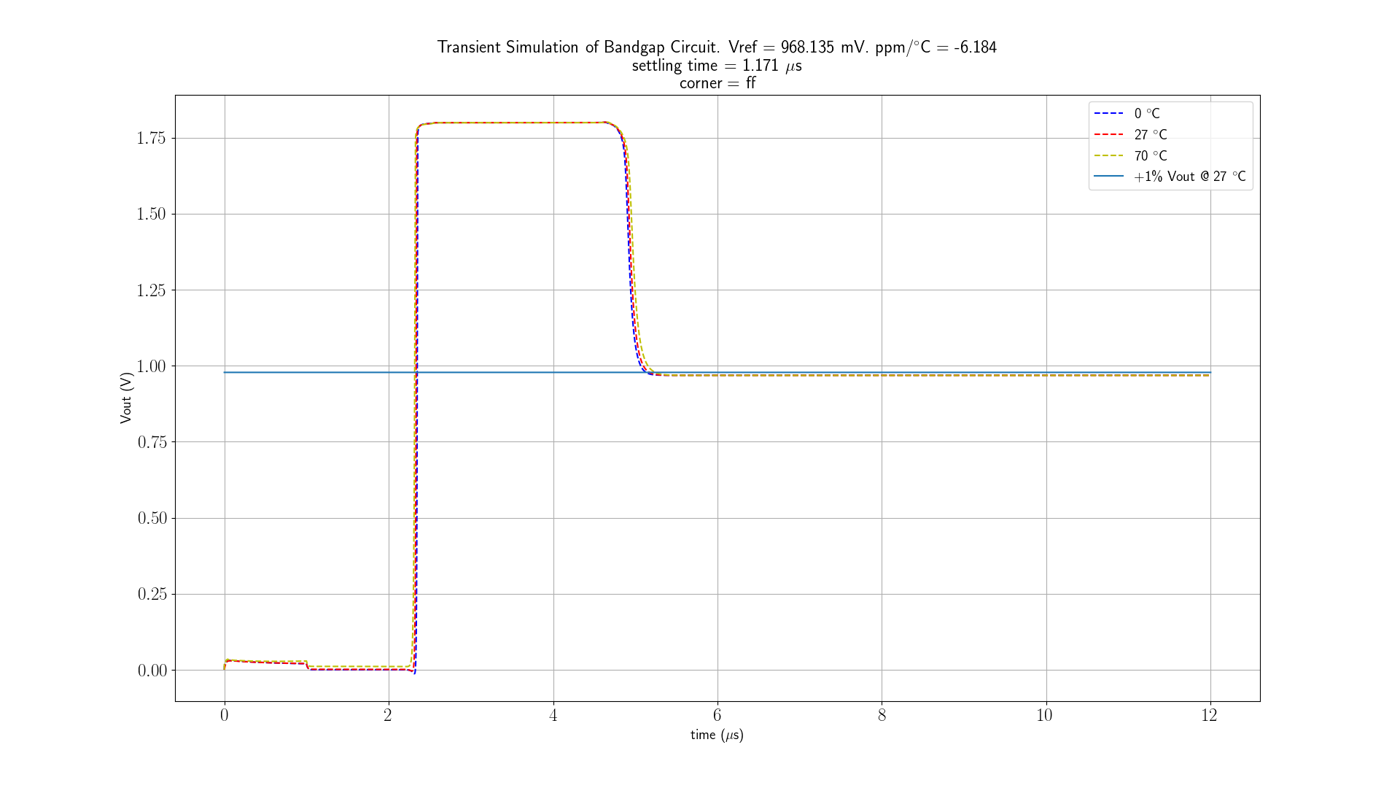
plots/layout-checkpoint/ppm_ff.png
