johnkustin/bandgapReferenceCircuit/plots/layout-checkpoint/ppm_ss.png

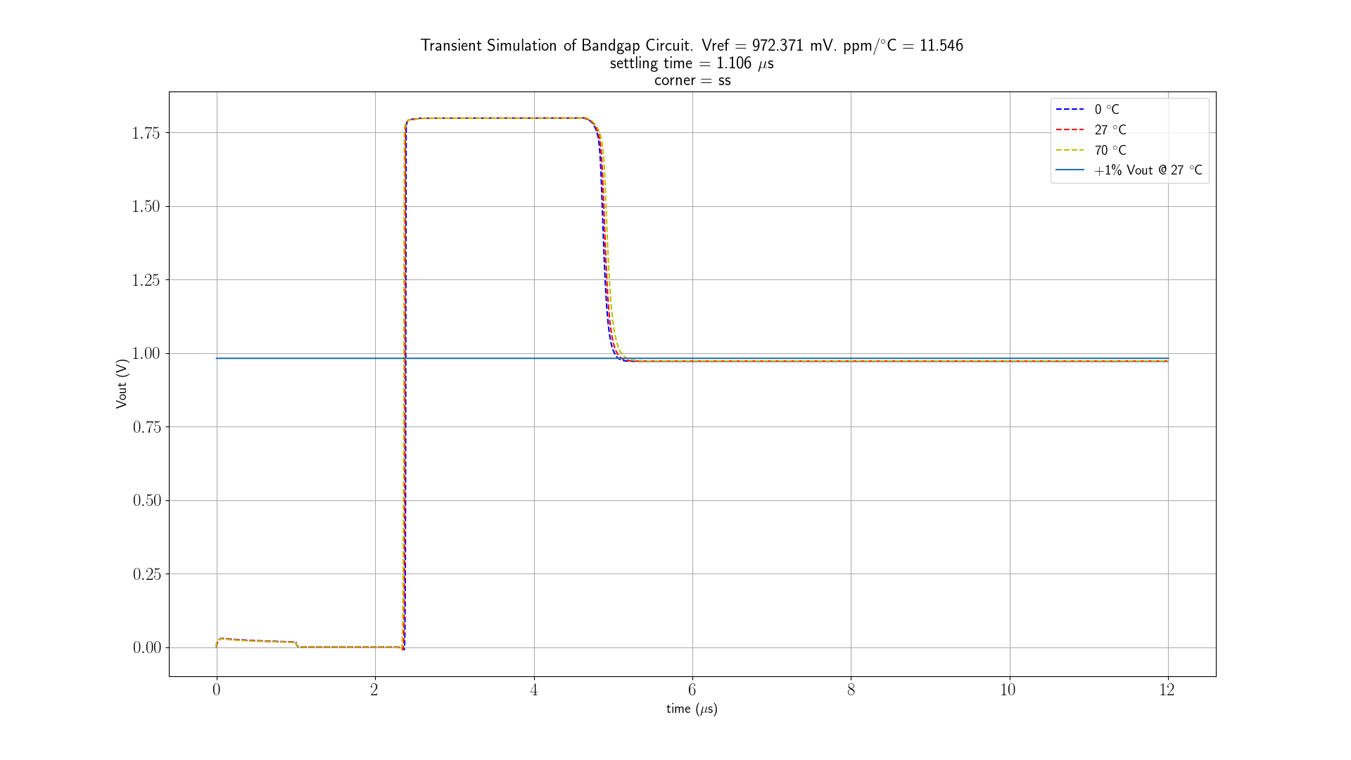
plots/layout-checkpoint/ppm_ss.png
