johnkustin/bandgapReferenceCircuit/plots/mid-quarter-review/TC.png

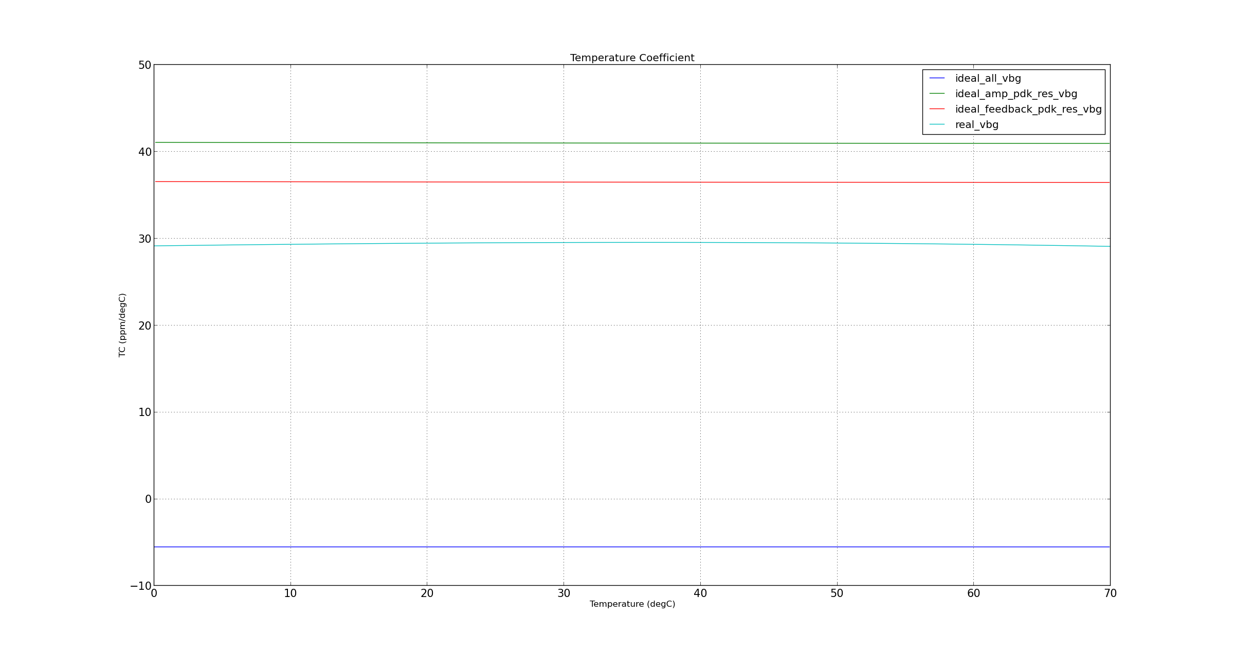
plots/mid-quarter-review/TC.png
