johnkustin/bandgapReferenceCircuit/plots/mid-quarter-review/vbg.png

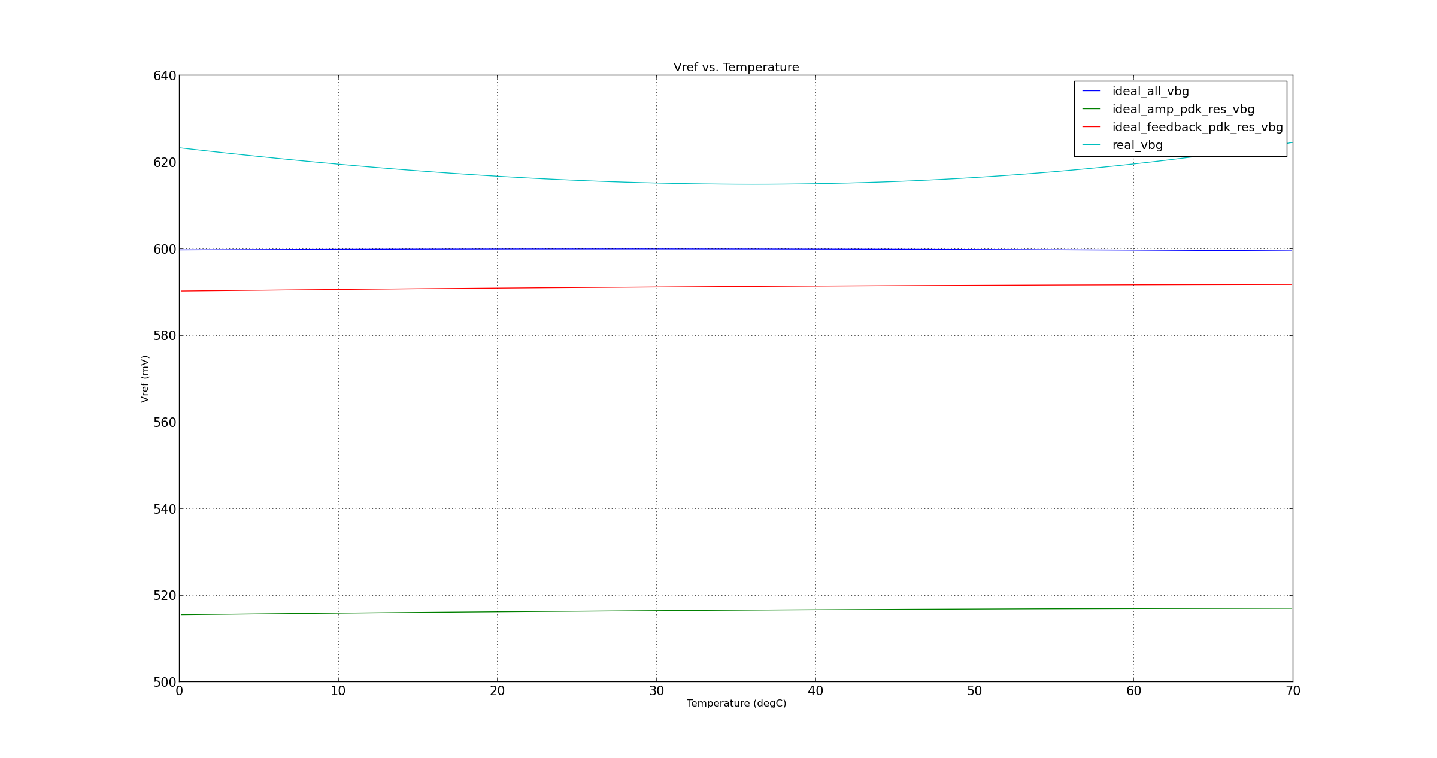
plots/mid-quarter-review/vbg.png
