johnkustin/bandgapReferenceCircuit/plots/readme/tempsweep.png

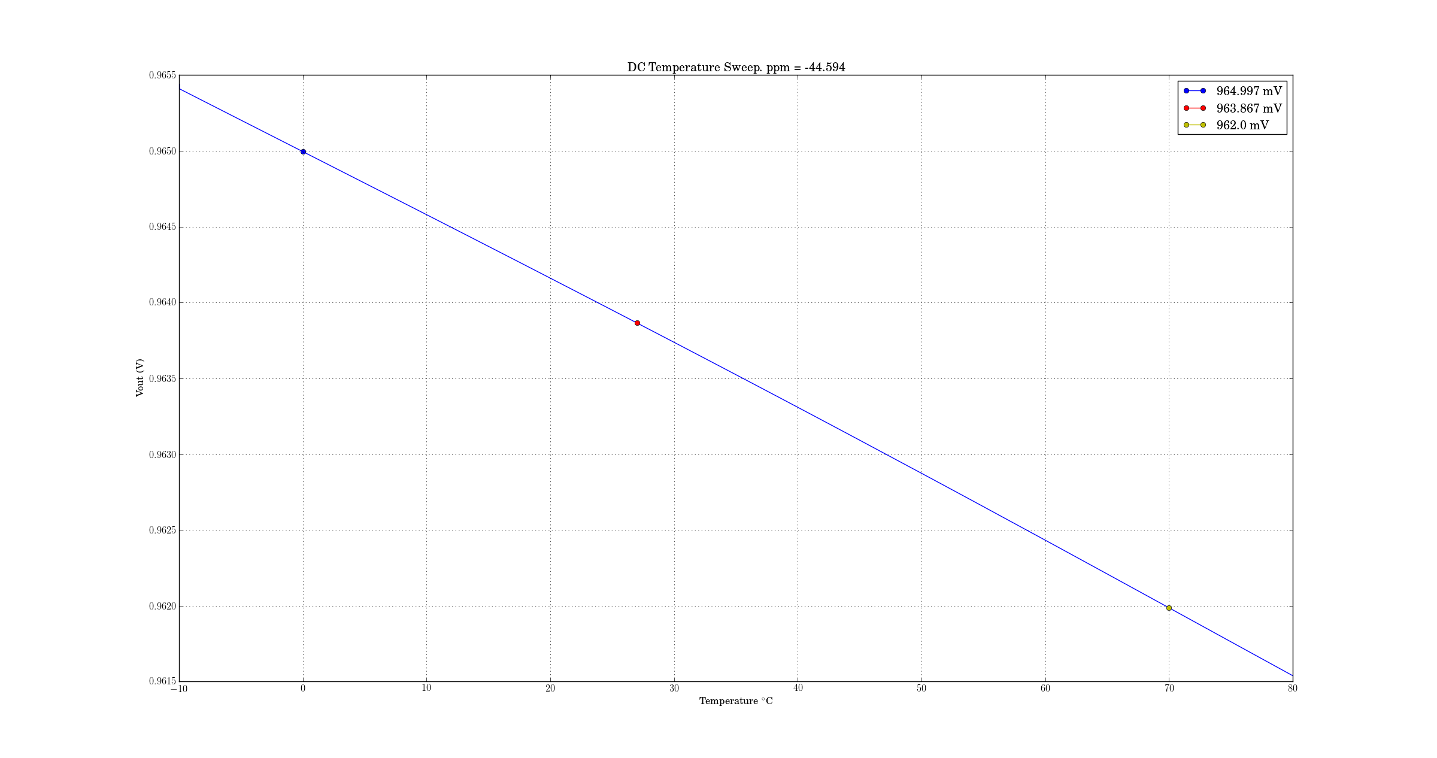
plots/readme/tempsweep.png
