johnkustin/bandgapReferenceCircuit/plots/readme/tran.png

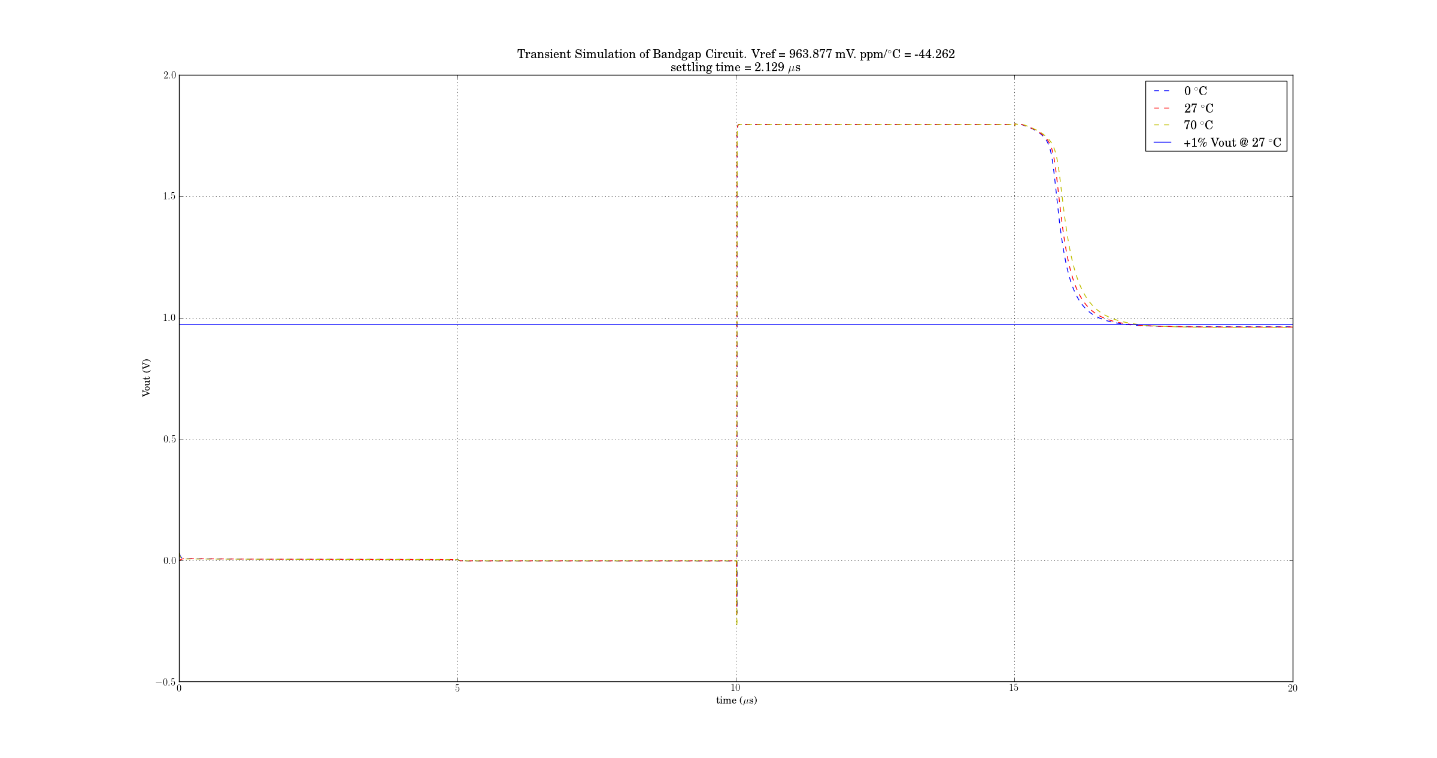
plots/readme/tran.png
