johnkustin/bandgapReferenceCircuit/plots/readme/tran_gauss.png

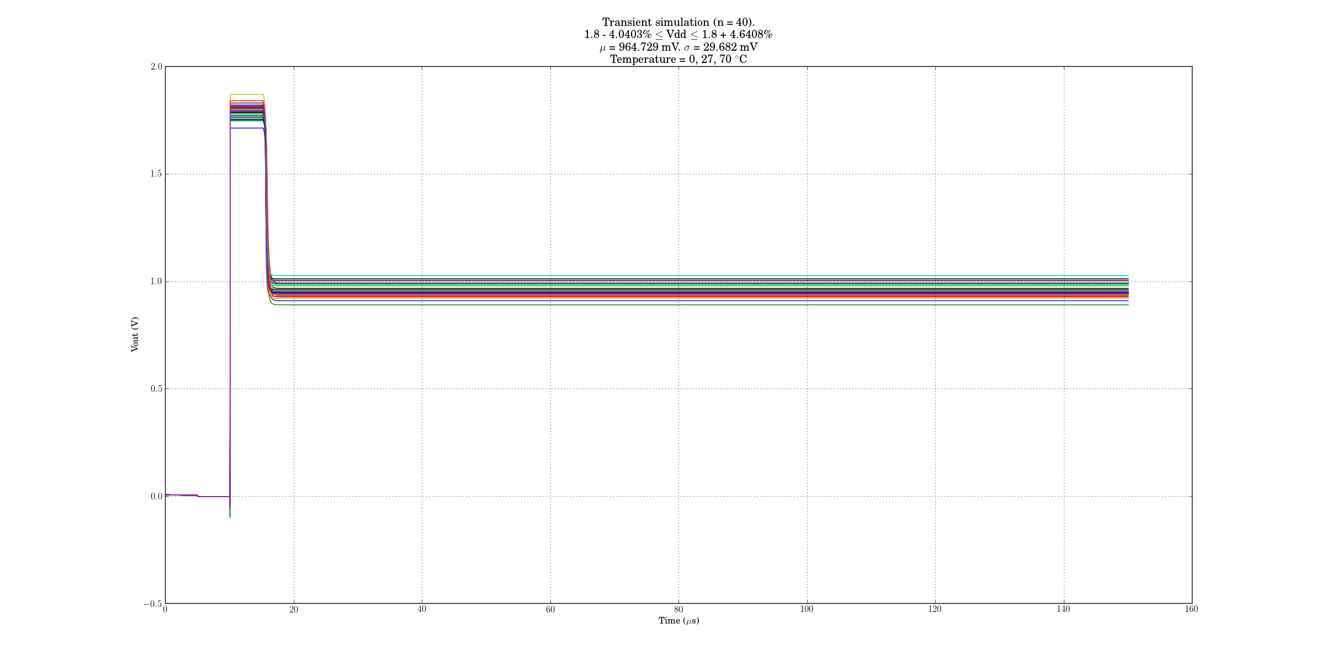
plots/readme/tran_gauss.png
