johnkustin/bandgapReferenceCircuit/schematics/tsmc-bandgap-real.png

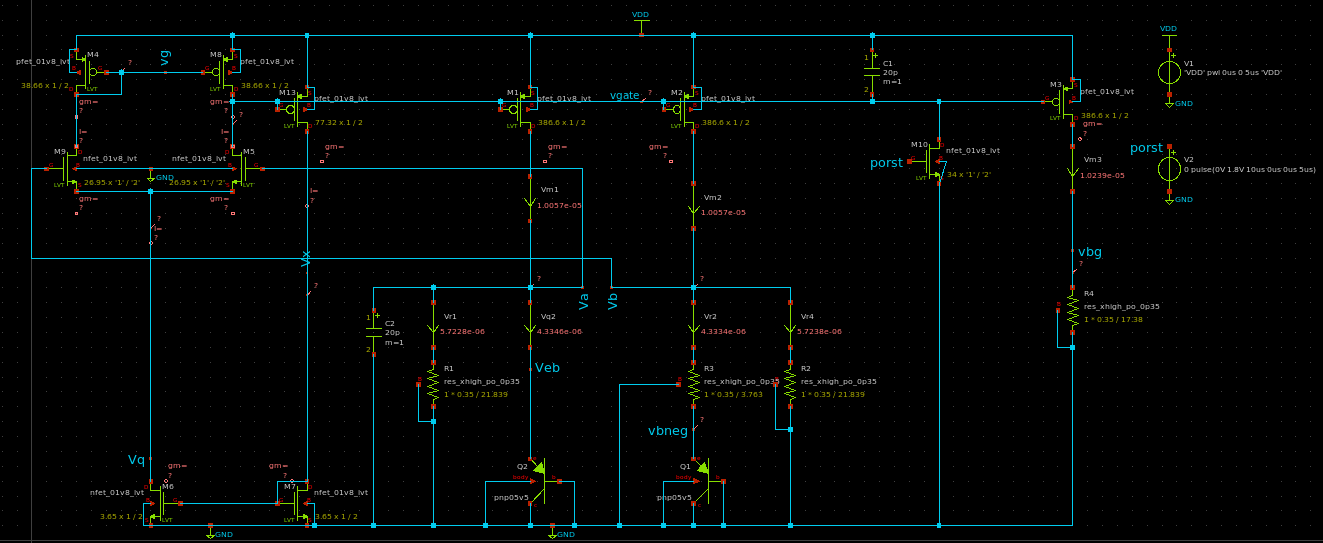
schematics/tsmc-bandgap-real.png
