johnkustin/bandgapReferenceCircuit/simulation_post_processing/pnpCTAT.png

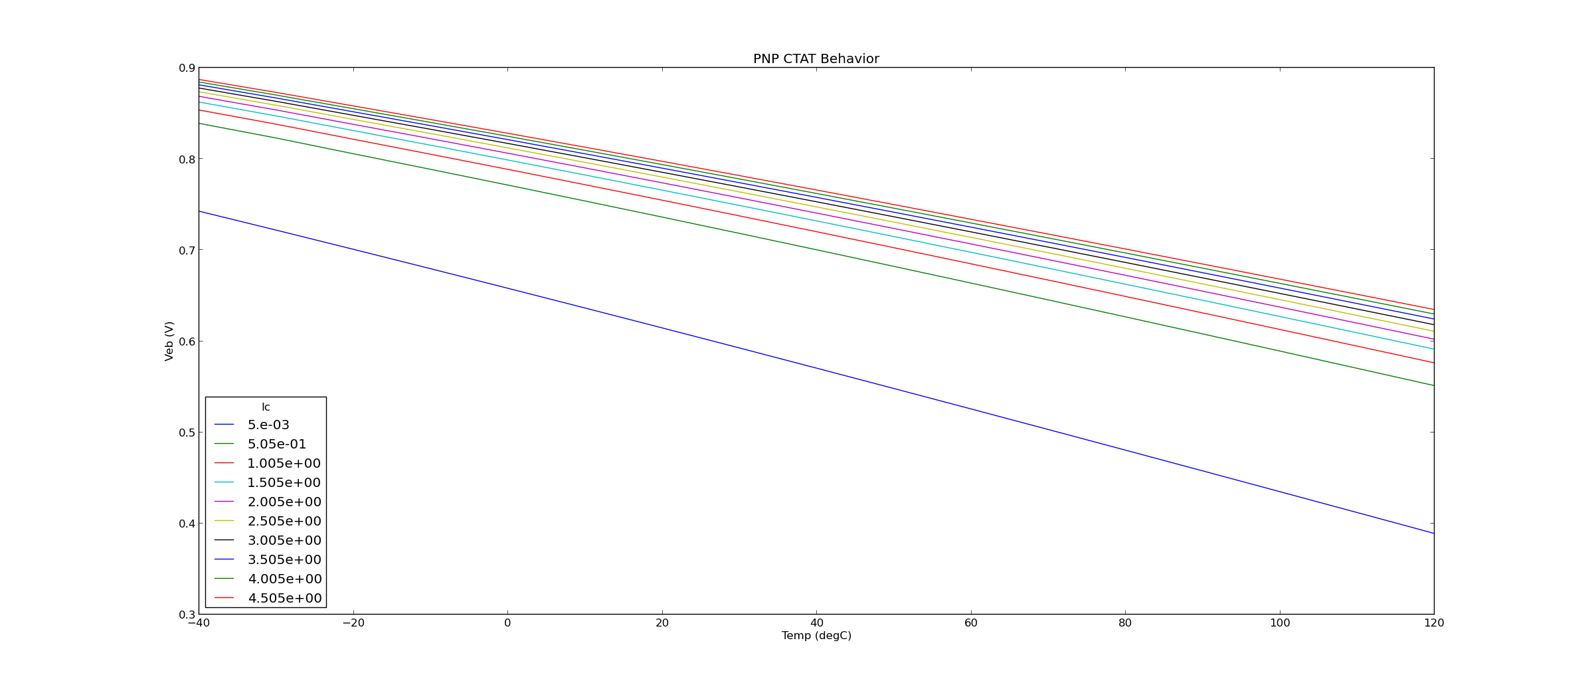
simulation_post_processing/pnpCTAT.png
