johnkustin/bandgapReferenceCircuit/simulation_post_processing/pnpCTATderivative.png

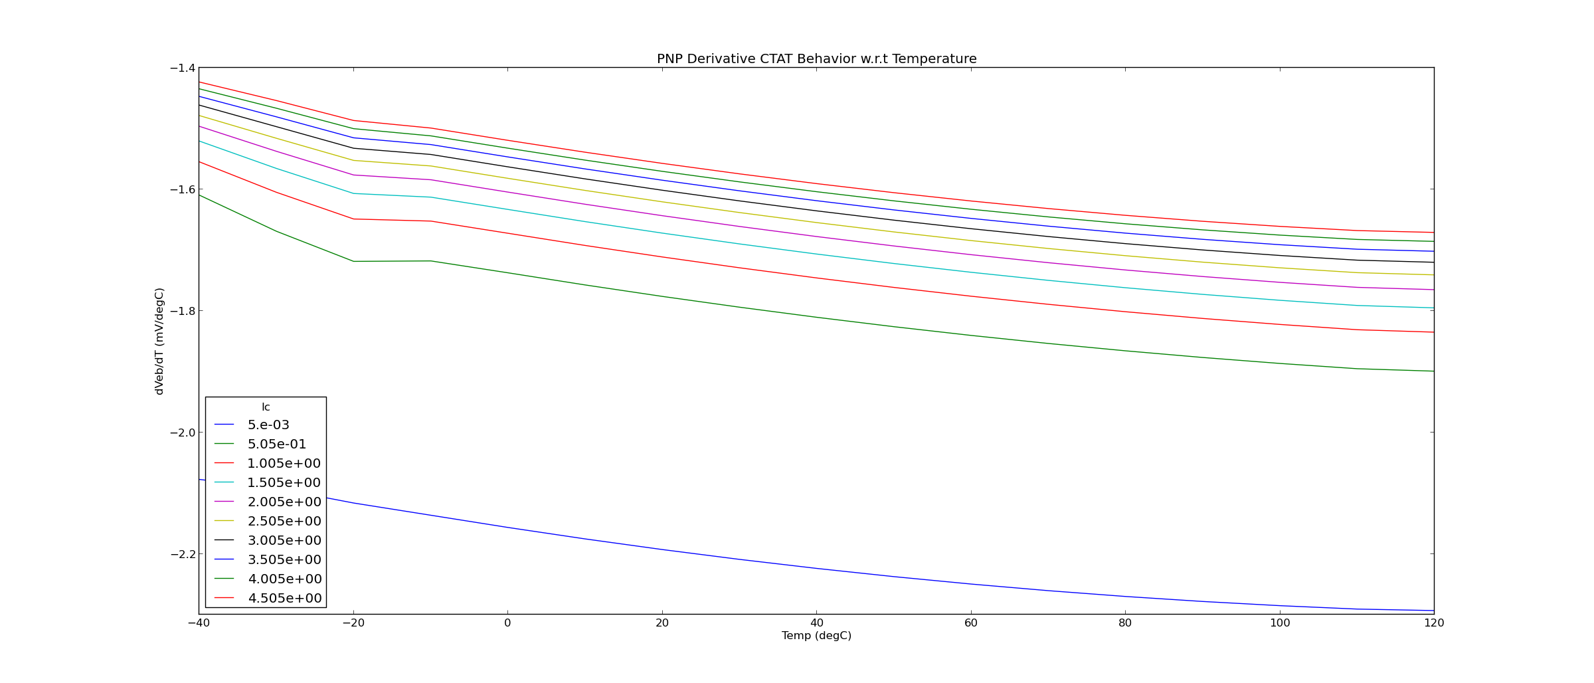
simulation_post_processing/pnpCTATderivative.png
