johnkustin/bandgapReferenceCircuit/slides/bgrslides.001.jpeg

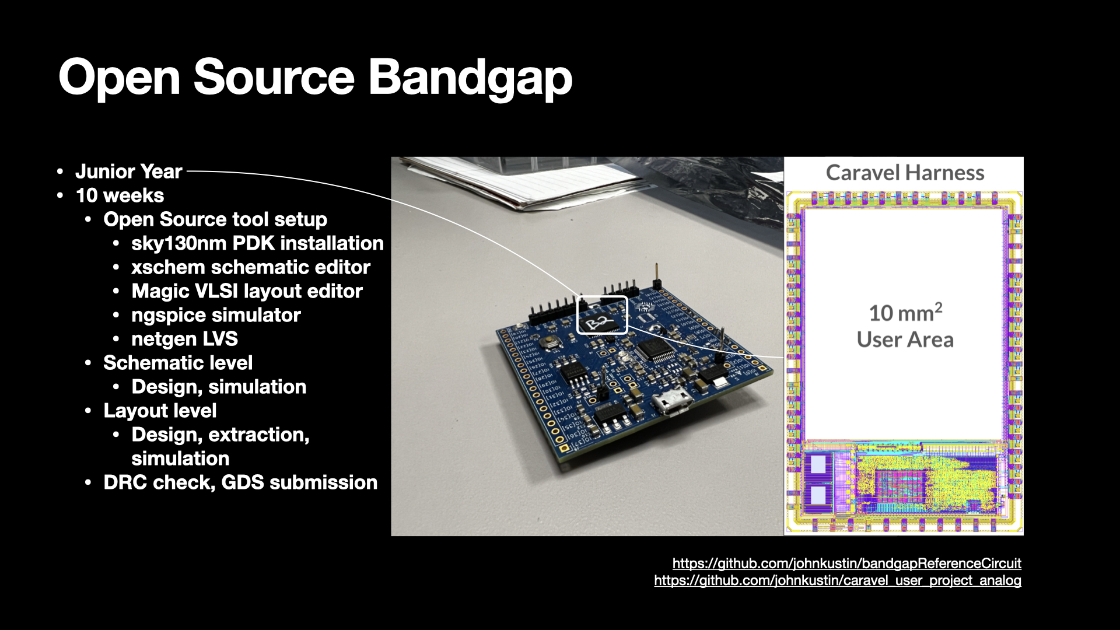
slides/bgrslides.001.jpeg
