johnkustin/bandgapReferenceCircuit/slides/bgrslides.002.jpeg

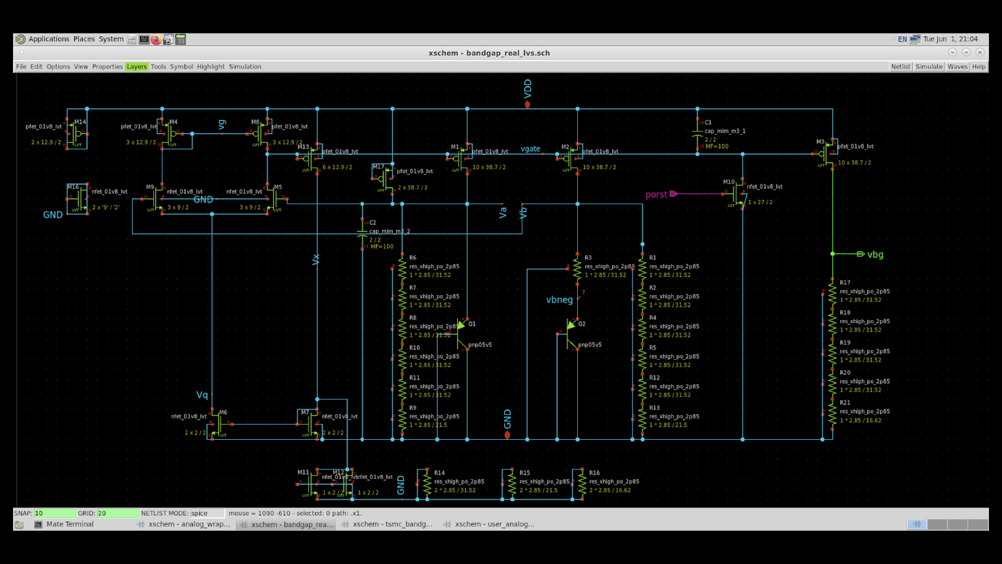
slides/bgrslides.002.jpeg
