johnkustin/bandgapReferenceCircuit/slides/bgrslides.003.jpeg

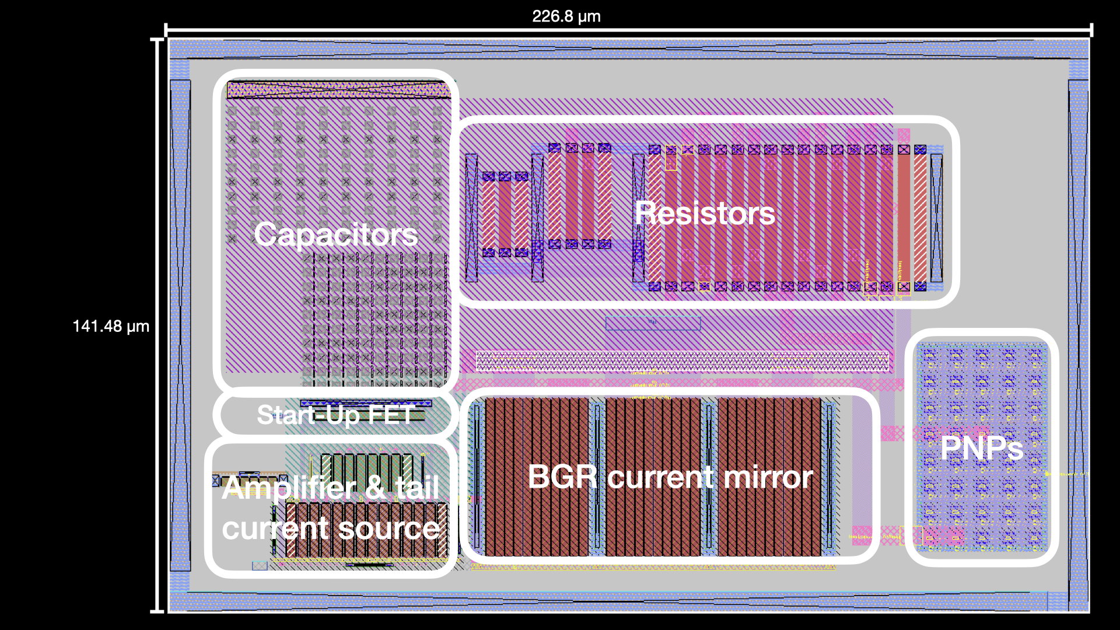
slides/bgrslides.003.jpeg
