johnkustin/bandgapReferenceCircuit/firmware/bgr_flash_arduino_reset_instructions.docx

1. select USB device of the caravel board in the top right corner of UTM (check what the arduino usb address is to rule out options)

2. connect to the arduino

3. flash the caravel board, remember to hold down the rst button until the flashing process begins

make clean flash

other notes

the VDD supply is derived from “vccd1”
