johnkustin/bandgapReferenceCircuit/imgs/bipolar-characterization-plot.png

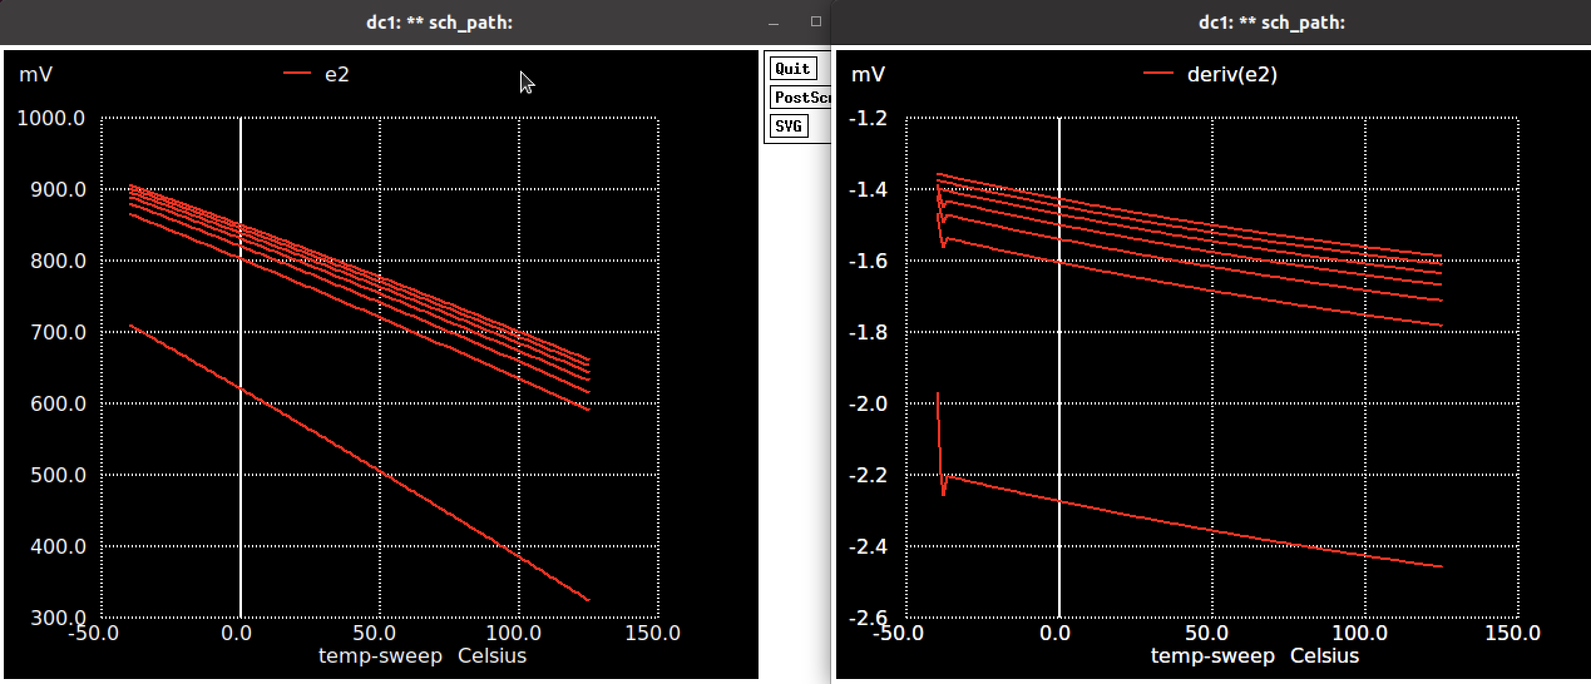
imgs/bipolar-characterization-plot.png
