johnkustin/bandgapReferenceCircuit/schematics/ideal_performance_bandgap.png

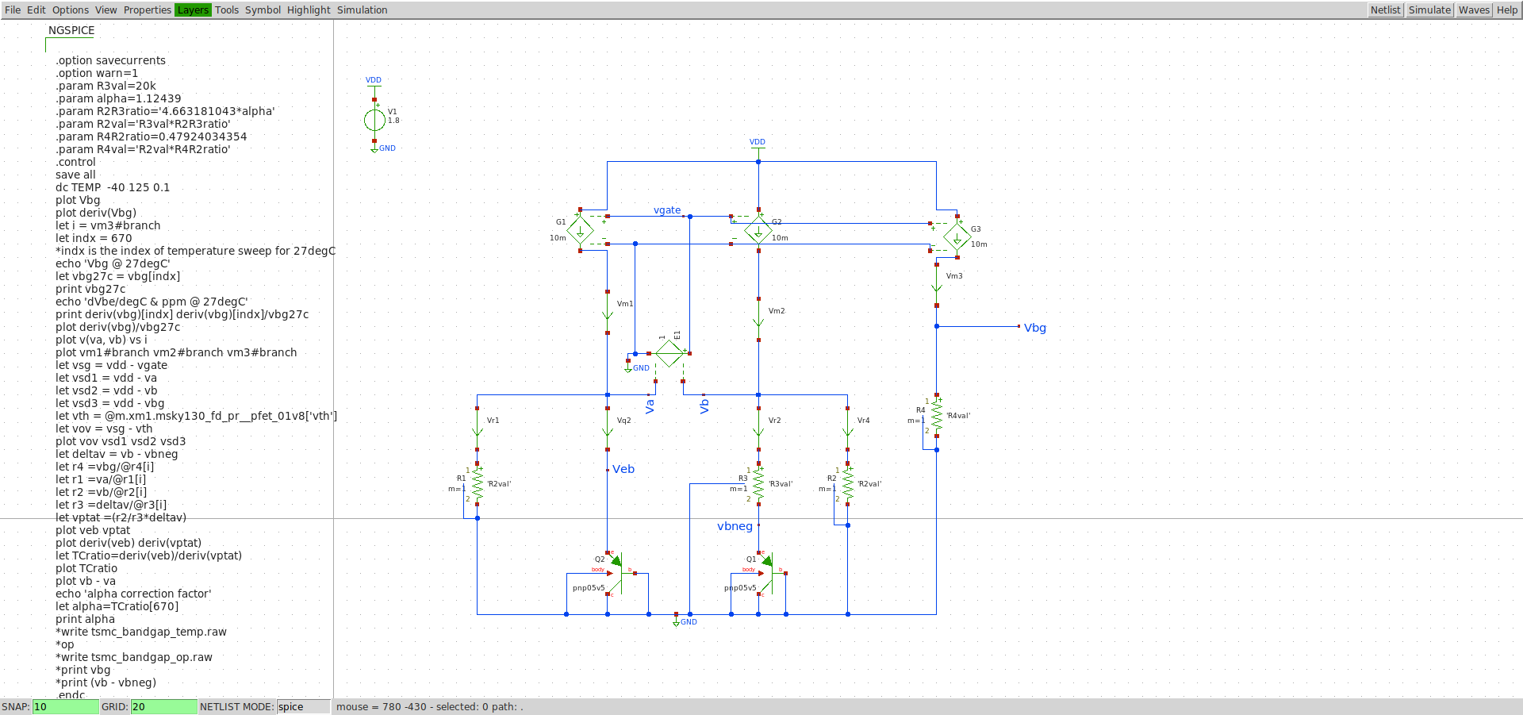
schematics/ideal_performance_bandgap.png
