johnkustin/bandgapReferenceCircuit/(threads)

Thread 1 (2023-03-18):

Final Schematic and testbench schematics?

curtisma, 2023-03-18:
Is the final schematic included in the repo?

I'm working on trying to rerun your sims and couldn't find the schematic shown in your readme.

The schematics that start with "tsmc" in "/schematics" are just examples and not the actual design, correct?
When I simulate dc op testbench "tsmc_bandgap_real_op.sch" I get a bandgap output voltage around 0.5v rather than 1v.

curtisma, 2023-03-18:
Actually, I think I figured out that the "tsmc_bandgap_real_op.sch" schematic works.  It just needed a fix to the multiplier of the larger PNP device, instance Q1.

Original properties of Q1 with m=39 as part of the model (note that the multiplier annotation is also wrong):
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

Fixed Q1 properties with a separate "m=39" declaration.

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

curtisma, 2023-03-18:
Why do you all the schematics have a "tsmc_" prefix when this is a Skywater SKY130 design?

johnkustin, 2023-04-02:
Totally valid question. The prefix is confusing. I shake my head when I judge the organization of this repo. But we all start somewhere lol.

The first bandgap paper I read was from a TSMC group, hence the prefix. Not that deep of an explanation. FWIW, I now appreciate having a clear, established naming convention. I'll leave this issue up so I eventually go through and tidy up the repo and naming of files.

The paper I read:
C. -H. Chang, J. -J. Horng, A. Kundu, C. -C. Chang and Y. -C. Peng, "An ultra-compact, untrimmed CMOS bandgap reference with 3σ inaccuracy of +0.64% in 16nm FinFET," 2014 IEEE Asian Solid-State Circuits Conference (A-SSCC), KaoHsiung, Taiwan, 2014, pp. 165-168, doi: 10.1109/ASSCC.2014.7008886.

 https://ieeexplore.ieee.org/document/7008886

Sorry for the unnecessary confusion that this naming convention may have created.

curtisma, 2023-04-03:
ok, I see, thanks, well we worked on cleaning up the [repo of our Fork](https://github.com/cascode-labs/bandgapReferenceCircuit).  It is essentially the same design, but it is better organized, both in terms of the repo and the schematics using hierarchy.  It also runs it in a devcontainer to improve the run reproducibility.
