johnkustin/bandgapReferenceCircuit/(commit log)

2021-03-23 finished characterization on 1.8V nmos and HVT pmos with width=0.65
2021-03-31 generated negative temperature dependence graph for pnp transistors
    [bipolar_characterization_scale_current.sch, bipolar_characterization_temp_and_vbe.sch]
2021-03-31 computed the derivative of CTAT dependence w.r.t temperature and across different emitter currents
2021-04-07 schematic w/ ideal E and w/ folded cascode
    [bipolar_characterization_temp_and_vbe_3p40.sch, hvt_pmos_char.sch, ptat_ctat_explore.sch, tsmc_bandgap.sch, tsmc_bandgap_w_amp.sch]
2021-04-07 new script changes
    [tsmc_bandgap.sch]
2021-04-09 ideal bandgap works now with 0.9490716 ppm/degC
    [delta_vbe_ex.sch, i-mirror-ref.sch, tsmc_bandgap.sch]
2021-04-09 added picture of schematic for ideal bandgap
2021-04-10 gmid lookup working with RVT cells. added new plots
    [bipolar_characterization_scale_current.sch, tsmc_bandgap.sch]
2021-04-16 added amplifier symbol. split bgr schematic into different levels of ideality. updated mosfet scaling scripts
    [amplifier-only-ckt.sch, amplifier.sch, i-mirror-ref.sch, temp-res-test.sch, tsmc_bandgap_ideal_all.sch, tsmc_bandgap_ideal_feedback.sch, tsmc_bandgap_ideal_feedback_pdk_res.sch, tsmc_bandgap_ideal_res_amp.sch]
2021-04-16 plots for real resistors. real current mirror.
2021-04-16 circuit with only ideal amp. using temp dependent resistors, but not pdk ones
2021-04-22 new plots. ideal amplfier with pdk resistors
2021-04-23 real circuit in tsmc_bandgap_real_non_pdk_res.sch
    [amplifier_with_bias_current-only-ckt.sch, amplifier_with_bias_current.sch, startup-ckt.sch, tsmc_bandgap_ideal_amp.sch, tsmc_bandgap_ideal_amp_pdk_res.sch, tsmc_bandgap_real.sch, tsmc_bandgap_real_but_bias_current.sch, tsmc_bandgap_real_non_pdk_res.sch]
2021-04-24 76 ppm
    [amplifier.sch, tsmc_bandgap_real_non_pdk_res.sch]
2021-04-24 actually 31.3ppm on _best.sch
    [tsmc_bandgap_real_non_pdk_res_16ppm_bad_curvature.sch, tsmc_bandgap_real_non_pdk_res_best.sch]
2021-04-24 final design. 29.54 ppm using endpoints method
    [tsmc_bandgap_real_final.sch]
2021-04-30 start up works. all transistors meet vdsat margins
    [tsmc_bandgap_real.sch]
2021-04-30 44.262ppm. transient sims work
    [tsmc_bandgap_real.sch]
2021-04-30 schematic capture completed?
    [bipolar_characterization_temp_and_vbe_3p40.sch]
2021-05-02 added test specific schematics. updated gaussian transient sim. updated post processing scripts
    [amplifier.sch, tsmc_bandgap_ideal_all.sch, tsmc_bandgap_ideal_amp_pdk_res.sch, tsmc_bandgap_ideal_feedback_pdk_res.sch, tsmc_bandgap_real_midquarter.sch, tsmc_bandgap_real_non_pdk_res.sch, tsmc_bandgap_real_non_pdk_res_alternate_try.sch, tsmc_bandgap_real_op.sch]
2021-05-02 added pic of schematic
2021-05-02 added annotated schematic
2021-05-09 added lvs and magic directories and files. currentmirror passes netlist LVS, fails top level port matching, fails equivalence checks for property of W
    [bandgapCoreGold_lvs.sch, currentMirrorGold.sch, currentMirrorGold_lvs.sch]
2021-05-10 netlist lvs passes for bg core. property mismatches for R network lengths
    [bandgapCoreGold_lvs.sch]
2021-05-10 netlist lvs for bg core works with multiplicity. still having property mismatch
    [bandgapCore.sch]
2021-05-10 current mirror LVS matches exactly
2021-05-12 active load amplifier laid out. lvs matches 100%. added schematic with rounded up sizes of devices. the ppm is actually in the 30s, less than before. added versions of the bandgapcore layout to mess 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
    [amplifier.sch, amplifier_lvs.sch, tsmc_bandgap_real_tran_layout.sch]
2021-05-12 added dummy transistors to amplifier. added the 2x pfet current source for self biasing network in the amplifier layout mathcing scheme. added a schematic to test the effect of adjusting R lengths us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
    [amplifier.sch, tsmc_bandgap_real_tran_adjusted_res.sch]
2021-05-12 added dummy devices to currentmirror. lvs passes 100%
    [currentMirrorGold.sch]
2021-05-12 added dummies to amplifier nmos. lvs is 100%
    [amplifier.sch]
2021-05-12 dummy connection in currentmirror has G,S shorted to VDD. D left connected to shared drain
    [currentMirrorGold.sch]
2021-05-17 top level layout complete without capacitors. lvs needed
    [ampcurrentsource.sch, ampcurrentsource_lvs.sch, bandgapCore.sch, tsmc_bandgap_real_tran_layout.sch]
2021-05-17 lvs passes on top level design. only lvs issue is a property area mismatch for the PNP, which might be ignorable due to the absence of area info in the given spice models
    [ampcurrentsource.sch, currentMirrorGold.sch, tsmc_bandgap_real_lvs.sch, tsmc_bandgap_real_top_lvs.sch]
2021-05-19 added GND! port for LVS port mathcing
2021-05-19 current tb for debug
2021-05-19 xschem layout schematic
    [tsmc_bandgap_real_tran_layout.sch]
2021-05-19 xschem schematic completely representing the layout. tran and op versions of schem
    [tsmc_bandgap_real_op_layout.sch]
2021-05-21 working no pex sim from individually extracted subcells.
    [tsmc_bandgap_real_op_layout.sch, tsmc_bandgap_real_tran_layout.sch]
2021-05-21 post-extraction sim w/o pex matches that of pre-extraction simulation.
    [currentmirror_bandgapCore_test.sch]
2021-05-23 layout checkpoint. able to extract entire circuit, but there is a bug in extresist or ext2sim prevening the extraction of parasitic resistances. scripts are available to extract, simulate, and genera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
2022-09-25 caption cut off fix
2022-11-13 included firmware materials
2022-11-20 changed bipolar characterization schematic
    [bipolar_characterization_temp_and_vbe_3p40.sch]
2023-01-20 silicon testing data csv. plotting script. screwing around
    [data.csv]
